chcbaram/macro-touchpad/hadware/V1.0/BOM_MAIN-BD_PCB_2023-05-19.xlsx

No. | Quantity | Comment | Designator | Footprint | Value | Manufacturer Part | Manufacturer | Supplier Part | Supplier
1 | 3 | 10uF | C1,C8,C12 | C1206 | 10uF | CL31A106KBHNNNE | SAMSUNG(三星) | C13585 | LCSC
2 | 11 | 100nF | C2,C17,C18,C19,C20,C21,C22,C23,C24,C25,C26 | C0402 | 100nF | CL05B104KB54PNC | SAMSUNG(三星) | C307331 | LCSC
3 | 4 | 1uF | C3,C6,C7,C14 | C0402 | 1uF | CL05A105KA5NQNC | SAMSUNG(三星) | C52923 | LCSC
4 | 5 | 10pF | C4,C5,C13,C15,C16 | C0402 | 10pF | CL05C100JB5NNNC | SAMSUNG(三星) | C32949 | LCSC
5 | 2 | 10uF | C9,C10 | C0603 | 10uF | C0603X5R106M100NT | SANYEAR(叁叶源) | C466780 | LCSC
6 | 1 | 1uF | C11 | C0603 | 1uF | CL10A105KB8NNNC | SAMSUNG(三星) | C15849 | LCSC
7 | 8 | 533980471 | CN1,CN3,CN5,CN7,CN8,CN9,CN11,CN12 | CONN-SMD_4P-P1.25_533980471 |  | 533980471 | MOLEX | C234195 | LCSC
8 | 4 | 0533980271 | CN2,CN4,CN6,CN10 | CONN-SMD_2P-P1.25_053398-0X71 |  | 0533980271 | MOLEX | C122410 | LCSC
9 | 2 | NSR0320MW2T1G | D1,D3 | SOD-323_L1.8-W1.3-LS2.5-RD |  | NSR0320MW2T1G | onsemi(安森美) | C48192 | LCSC
10 | 1 | MSK4010 | D2 | SOD-523_L1.2-W0.8-LS1.6-RD |  | MSK4010 | SHIKUES(时科) | C345958 | LCSC
11 | 1 | FPC-05FB-40PH20 | FPC1 | FPC-SMD_40P-P0.50_XUNPU_FPC-05FB-40PH20 |  | FPC-05FB-40PH20 | XUNPU(讯普) | C2856837 | LCSC
12 | 8 | HOLE | H1,H2,H3,H4,H5,H6,H7,H8 | HOLEHOLE
13 | 1 | 10uH | L1 | IND-SMD_L2.5-W2.0-1 | 10uH | VLS252012HBU-100M | TDK | C434844 | LCSC
14 | 1 | GHC-YR1S2-EMERALD | LED1 | LED0603-RD |  | GHC-YR1S2-EMERALD | EVERLIGHT(亿光) | C72043 | LCSC
15 | 1 | Y2C-CQ2R2L-YELLOW | LED2 | LED0603-RD-YELLOW |  | Y2C-CQ2R2L-YELLOW | EVERLIGHT(亿光) | C72038 | LCSC
16 | 2 | 19-213/Y2C-CQ2R2L/3T(CY) | LED4,LED5 | LED0603-RD-YELLOW |  | 19-213/Y2C-CQ2R2L/3T(CY) | EVERLIGHT(亿光) | C72038 | LCSC
17 | 1 | XL-1608SURC-06 | LED7 | LED0603-RD_RED |  | XL-1608SURC-06 | XINGLIGHT(成兴光) | C965799 | LCSC
18 | 1 | WS2812C-2020-V1 | LED8 | LED-SMD_4P-L2.0-W2.0-TL_WS2812B-2020 |  | WS2812C-2020-V1 | worldsemi | C2976072 | LCSC
19 | 2 | DMG3415U-7 | Q1,Q2 | SOT-23-3_L2.9-W1.6-P1.90-LS2.8-BR-CW |  | DMG3415U-7 | DIODES(美台) | C96616 | LCSC
20 | 1 | MMBT2222A 1P | Q3 | SOT-23-3_L2.9-W1.3-P1.90-LS2.4-BR |  | MMBT2222A 1P | CJ(江苏长电/长晶) | C8512 | LCSC
21 | 1 | FS8205 | Q4 | SOT-23-6_L2.9-W1.6-P0.95-LS2.8-BR |  | FS8205 | FORTUNE(富晶) | C32254 | LCSC
22 | 5 | 0Ω | R1,R5,R6,R15,R19 | R0402 | 0Ω | 0402WGF0000TCE | UNI-ROYAL(厚声) | C17168 | LCSC
23 | 13 | 10kΩ | R2,R8,R11,R16,R27,R28,R29,R32,R33,R34,R35,R36,R37 | R0402 | 10kΩ | 0402WGF1002TCE | UNI-ROYAL(厚声) | C25744 | LCSC
24 | 2 | 27Ω | R3,R4 | R0402 | 27Ω | 0402WGF270JTCE | UNI-ROYAL(厚声) | C25100 | LCSC
25 | 3 | 5.1kΩ | R7,R17,R20 | R0402 | 5.1kΩ | 0402WGF5101TCE | UNI-ROYAL(厚声) | C25905 | LCSC
26 | 6 | 1kΩ | R9,R12,R14,R24,R40,R42 | R0402 | 1kΩ | 0402WGF1001TCE | UNI-ROYAL(厚声) | C11702 | LCSC
27 | 3 | 100kΩ | R10,R38,R39 | R0402 | 100kΩ | 0402WGF1003TCE | UNI-ROYAL(厚声) | C25741 | LCSC
28 | 3 | 470Ω | R13,R43,R44 | R0402 | 470Ω | 0402WGF4700TCE | UNI-ROYAL(厚声) | C25117 | LCSC
29 | 1 | 2.74Ω | R22 | R0603 | 2.74Ω | RS-03L2R74FT | FH(风华) | C322128 | LCSC
30 | 1 | 1MΩ | R23 | R0603 | 1MΩ | 0603WAF1004T5E | UNI-ROYAL(厚声) | C22935 | LCSC
31 | 4 | 120Ω | R25,R26,R30,R31 | R0603 | 120Ω | 0603WAF1200T5E | UNI-ROYAL(厚声) | C22787 | LCSC
32 | 1 | 100Ω | R41 | R0402 | 100Ω | 0402WGF1000TCE | UNI-ROYAL(厚声) | C25076 | LCSC
33 | 1 | 3.3kΩ | R45 | R0402 | 3.3kΩ | 0402WGF3301TCE | UNI-ROYAL(厚声) | C25890 | LCSC
34 | 3 | SKRPACE010 | SW1,SW2,SW3 | KEY-SMD_4P-L4.2-W3.2-P2.20-LS4.6 |  | SKRPACE010 | ALPSALPINE(阿尔卑斯阿尔派) | C139797 | LCSC
35 | 2 | Device_RotaryEncoder_Switch | SW4,SW5 | Rotary_Encoder:RotaryEncoder_Alps_EC11E-Switch_Vertical_H20mm | RotaryEncoder_Switch
36 | 2 | DHN-04-V-T/R | SW6,SW7 | SW-TH_DHN-04-V-T-R |  | DHN-04-V-T/R | 圜达 | C224996 | LCSC
37 | 1 | ESP32-S3-WROOM-1-N16R8 | U1 | WIRELM-SMD_ESP32-S3-WROOM-1 |  | ESP32-S3-WROOM-1-N16R8 | ESPRESSIF(乐鑫) | C2913202 | LCSC
38 | 4 | SP3485EEN | U2,U5,U20,U21 | SOP-8_L5.0-W4.0-P1.27-LS6.0-BL |  | SP3485EEN | UMW(广东友台半导体) | C668205 | LCSC
39 | 1 | XC6210B332MR | U3 | TSOT-23-5_L2.9-W1.6-P0.95-LS2.8-BR |  | XC6210B332MR | TOREX(特瑞仕) | C424705 | LCSC
40 | 1 | TP4056-42-ESOP8 | U4 | ESOP-8_L4.9-W3.9-P1.27-LS6.0-BL-EP |  | TP4056-42-ESOP8 | TOPPOWER(南京拓微) | C16581 | LCSC
41 | 2 | 533980671 | U6,U19 | CONN-SMD_6P-P1.25-V-M_533980671 |  | 533980671 | MOLEX | C277393 | LCSC
42 | 1 | STM32G070CBT6 | U7 | LQFP-48_L7.0-W7.0-P0.50-LS9.0-BL |  | STM32G070CBT6 | ST(意法半导体) | C529338 | LCSC
43 | 1 | TXB0101DBVR | U9 | SOT-23-6_L2.9-W1.6-P0.95-LS2.8-TL |  | TXB0101DBVR | TI(德州仪器) | C2652944 | LCSC
44 | 1 | MT9284-28J | U10 | SOT-23-6_L2.9-W1.6-P0.95-LS2.8-BR |  | MT9284-28J | 西安航天民芯 | C181780 | LCSC
45 | 1 | MAX98357AETE+T | U11 | TQFN-16_L3.0-W3.0-P0.50-BL-EP1.5 |  | MAX98357AETE+T | ADI(亚德诺)/MAXIM(美信) | C910544 | LCSC
46 | 1 | STM32G031G8U6 | U12 | UFQFPN-28_L4.0-W4.0-P0.50-BL |  | STM32G031G8U6 | ST(意法半导体) | C432211 | LCSC
47 | 1 | TTP233H-BA6 | U17 | SOT-23-6_L2.9-W1.7-P0.95-LS2.8-BL |  | TTP233H-BA6 | TONTEK(通泰) | C2890349 | LCSC
48 | 1 | SN74LVC1G74DCUR | U18 | SSOP-8_L2.0-W2.3-P0.50-LS3.1-BR |  | SN74LVC1G74DCUR | TI(德州仪器) | C70285 | LCSC
49 | 1 | DW01A | U23 | SOT-23-6_L2.9-W1.6-P0.95-LS2.8-BL |  | DW01A | TF(拓锋) | C436931 | LCSC
50 | 1 | 8MHz | X1 | CRYSTAL-SMD_4P-L3.2-W2.5-BL-2 | 8MHz | 7B008000I01 | HD(浩都频率) | C648985 | LCSC
