chcbaram/macro-touchpad/hadware/V1.0/Gerber_PCB_2023-05-19/How-to-order-PCB.txt

How to Order PCB

Please refer to:
https://docs.easyeda.com/en/PCB/Order-PCB
