chcbaram/macro-touchpad/hadware/V1.0/PDF_MACRO-TOUCHPAD_2023-05-19.pdf

IO0 27 IO35 28 IO36 29 IO37 30 IO38 31 IO39 32 IO40 33 IO41 34 IO42 35 RXD0 36 TXD0 37 IO2 38 IO1 39 GND 40

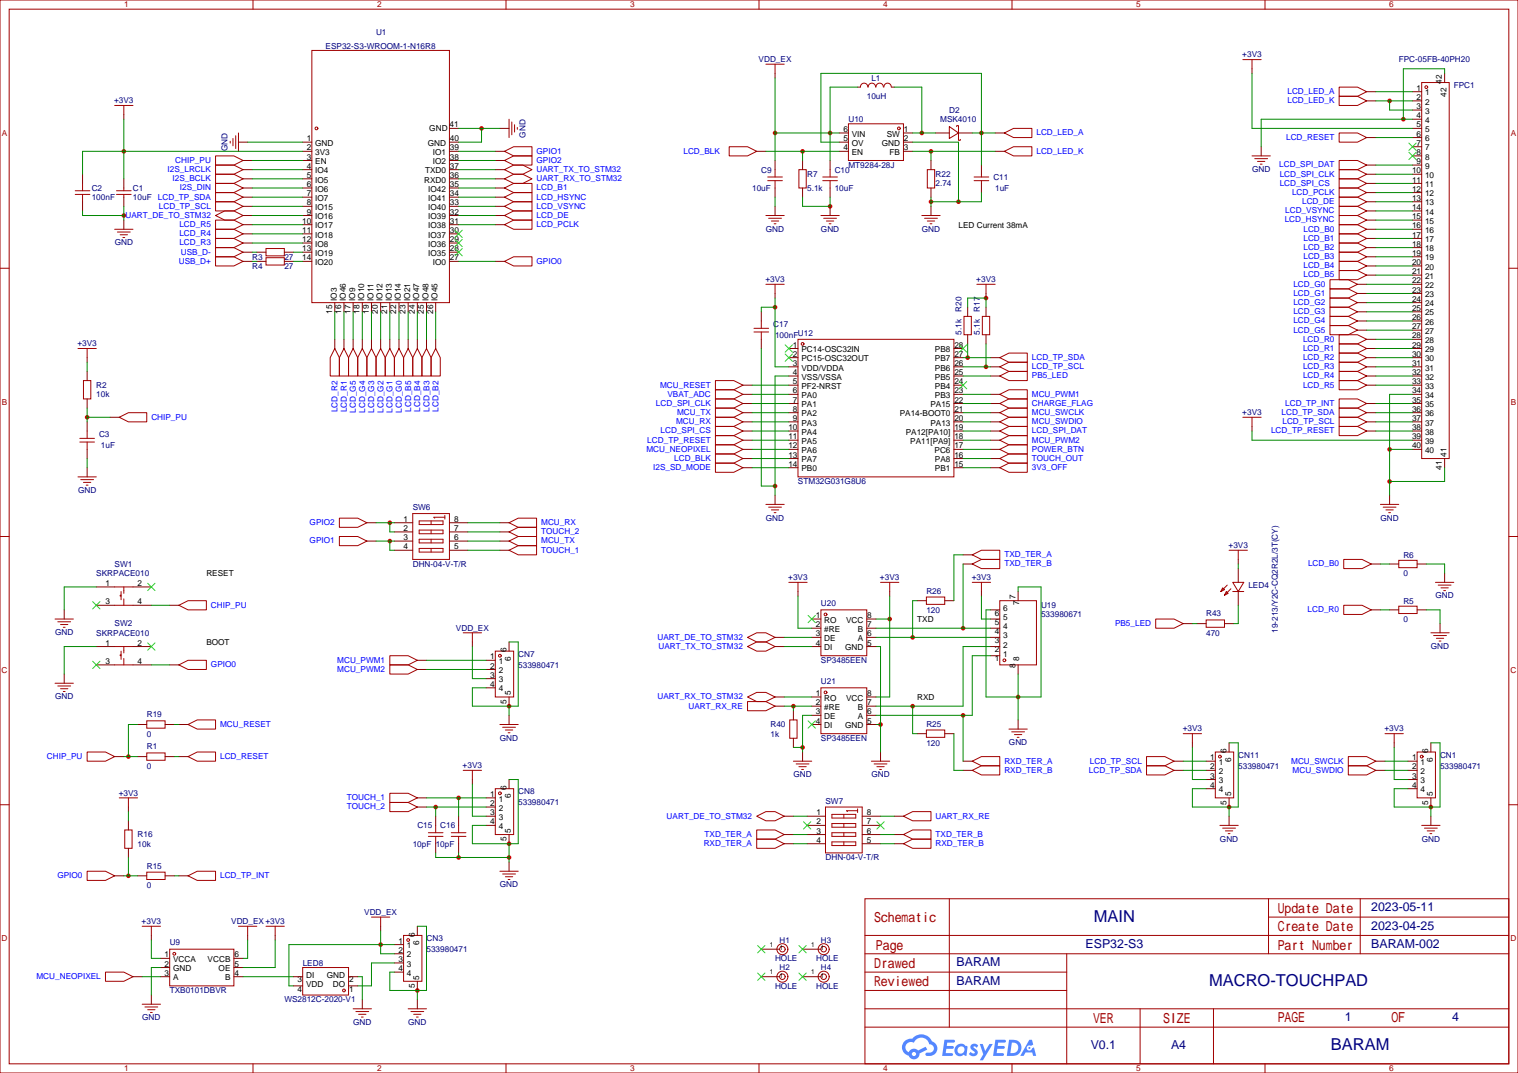
[picture p1: page 1]

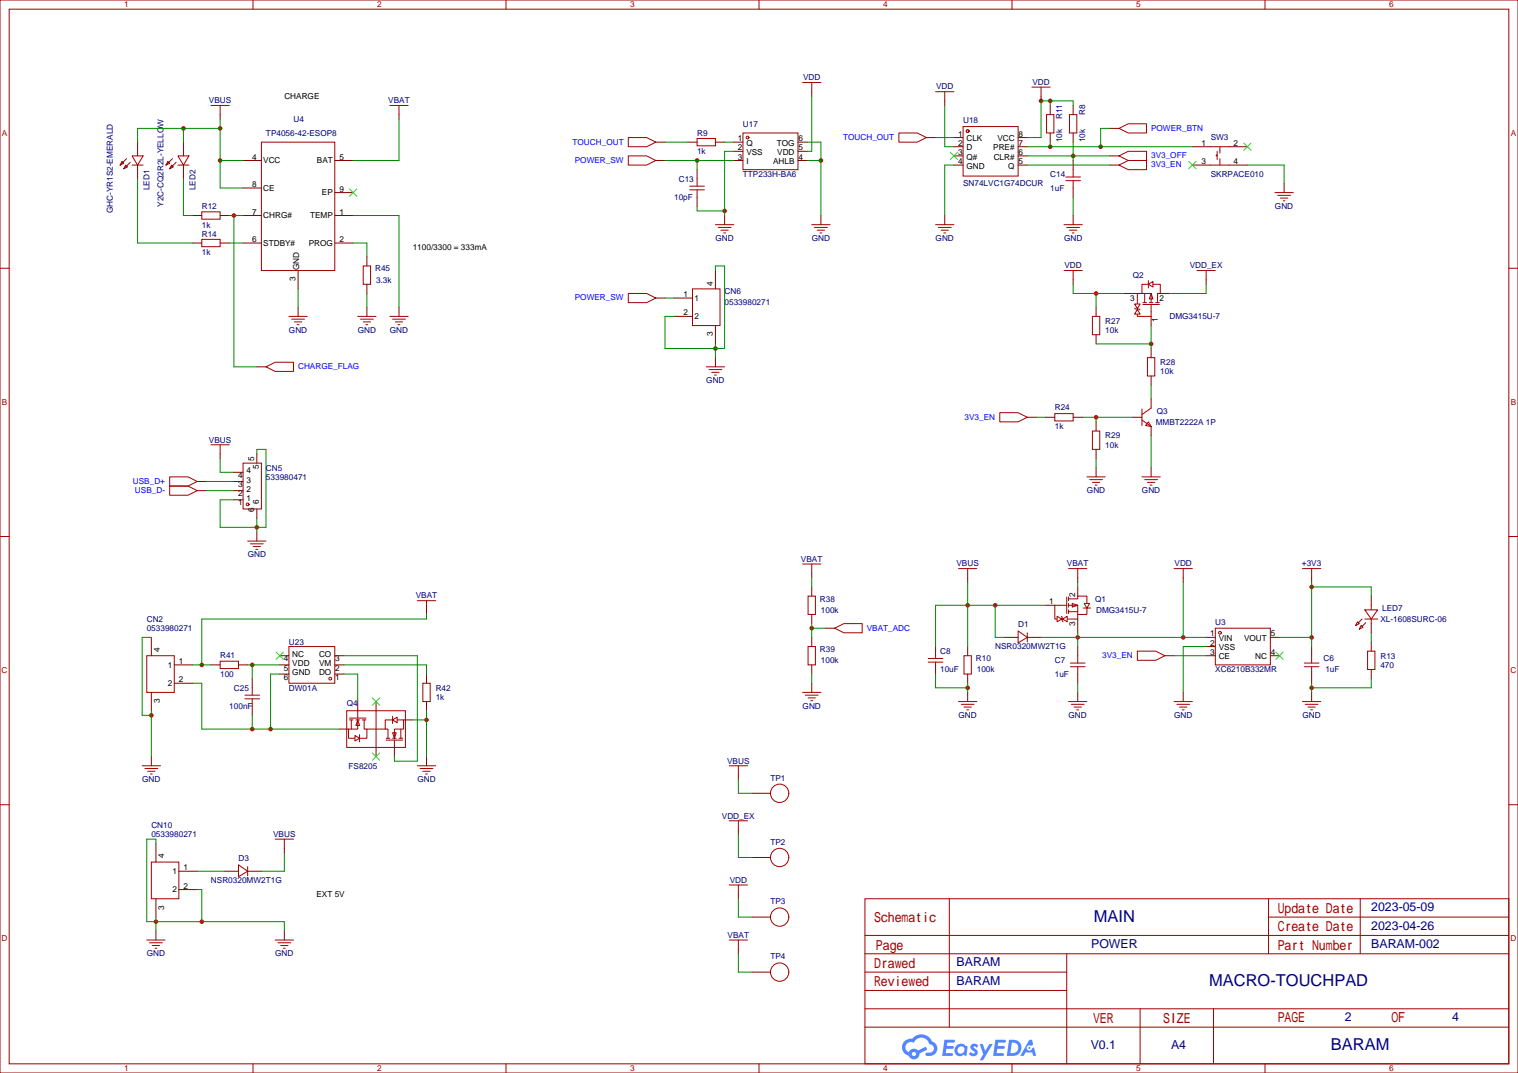
[picture p2: page 2]

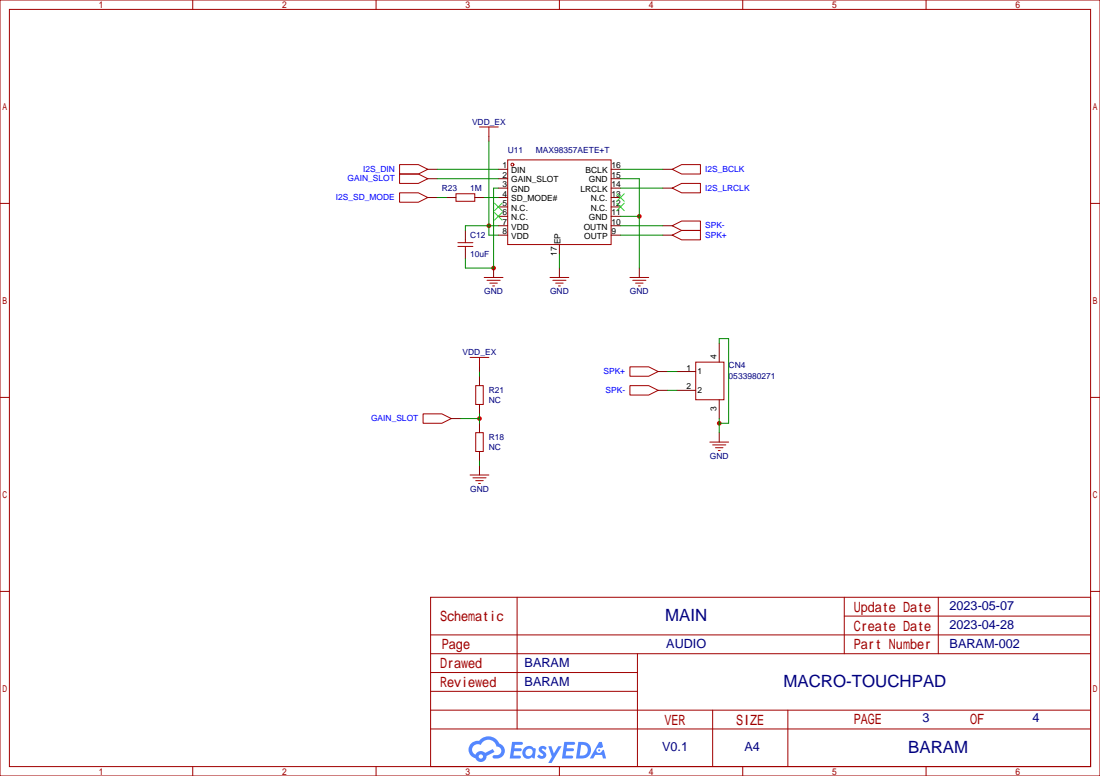
[picture p3: page 3]

OUTN 10 GND 11 N.C. 12 N.C. 13 LRCLK 14 GND 15 BCLK 16

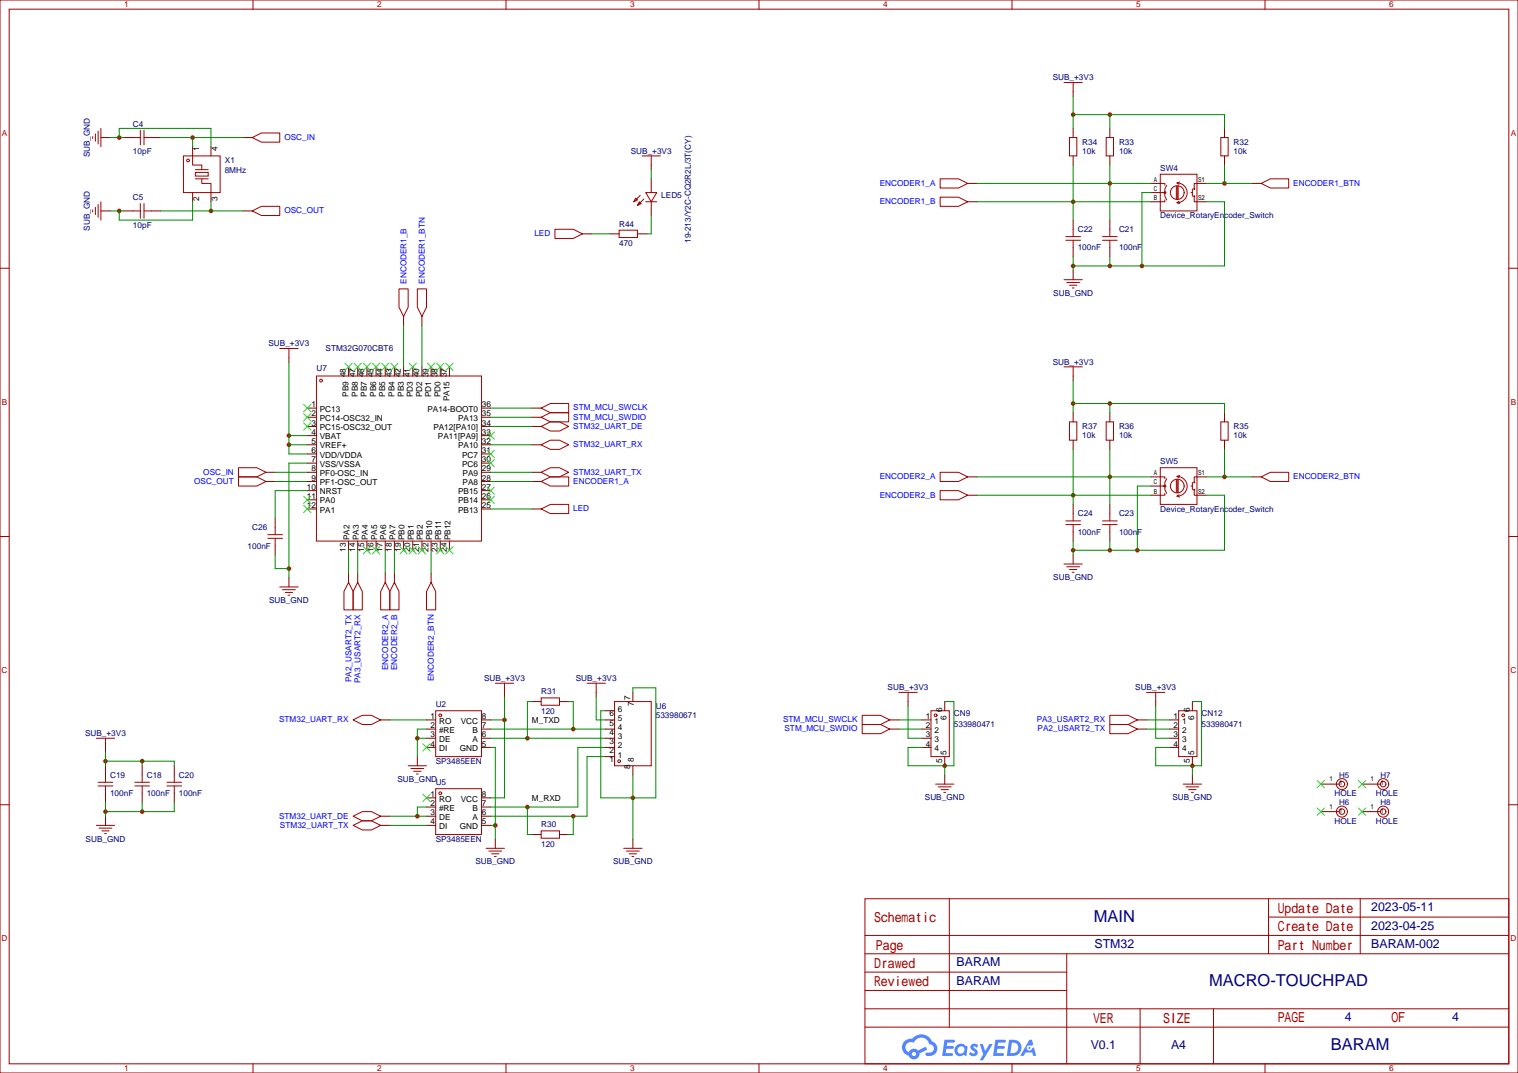
[picture p4: page 4]
