chcbaram/macro-touchpad/firmware/main-bd/stm32g031/cube/stm32g031g8.ioc

Mcu.UserName=STM32G031G8Ux
PA0.Signal=ADC1_IN0
PA1.Signal=SPI1_SCK
PA13.Signal=SYS_SWDIO
PA14-BOOT0.Signal=SYS_SWCLK
PA15.GPIO_Label=CHARGE_FLAG
PA15.Signal=GPIO_Input
PA2.Signal=USART2_TX
PA3.Signal=USART2_RX
PA4.Signal=SPI1_NSS
PA5.GPIO_Label=LCD_TP_RESET
PA5.Signal=GPIO_Output
PA6.Signal=S_TIM3_CH1
PA7.Signal=S_TIM14_CH1
PA8.GPIO_Label=TOUCH_OUT
PA8.Signal=GPIO_Input
PB0.GPIO_Label=I2S_SD_MODE
PB0.Signal=GPIO_Output
PB1.GPIO_Label=V3V3_OFF
PB1.Signal=GPIO_Output
PB3.Signal=S_TIM1_CH2
PB5.GPIO_Label=PB5_LED
PB5.Signal=GPIO_Output
PB6.Signal=I2C1_SCL
PB7.Signal=I2C1_SDA
PC6.GPIO_Label=POWER_BTN
PC6.Signal=GPIO_Input
