chcbaram/macro-touchpad/firmware/main-bd/stm32g031/cube/Core/Inc/main.h

#define LCD_TP_RESET_Pin GPIO_PIN_5
#define LCD_TP_RESET_GPIO_Port GPIOA
#define I2S_SD_MODE_Pin GPIO_PIN_0
#define I2S_SD_MODE_GPIO_Port GPIOB
#define V3V3_OFF_Pin GPIO_PIN_1
#define V3V3_OFF_GPIO_Port GPIOB
#define TOUCH_OUT_Pin GPIO_PIN_8
#define TOUCH_OUT_GPIO_Port GPIOA
#define POWER_BTN_Pin GPIO_PIN_6
#define POWER_BTN_GPIO_Port GPIOC
#define CHARGE_FLAG_Pin GPIO_PIN_15
#define CHARGE_FLAG_GPIO_Port GPIOA
#define PB5_LED_Pin GPIO_PIN_5
#define PB5_LED_GPIO_Port GPIOB
