chcbaram/macro-touchpad/firmware/main-bd/esp32-s3/components/esp32-s3-hal/hw/hw_def.h

/*
 * hw_def.h
 *
 *  Created on: 2021. 1. 9.
 *      Author: baram
 */

#ifndef MAIN_HW_HW_DEF_H_
#define MAIN_HW_HW_DEF_H_


#include "def.h"
#include "bsp.h"



#define _DEF_FIRMWATRE_VERSION    "V230520R1"
#define _DEF_BOARD_NAME           "MACRO-TOUCHPAD"



#define _HW_DEF_RTOS_THREAD_PRI_CLI           5
#define _HW_DEF_RTOS_THREAD_PRI_BUTTON        5
#define _HW_DEF_RTOS_THREAD_PRI_SD            5
#define _HW_DEF_RTOS_THREAD_PRI_LCD           5
#define _HW_DEF_RTOS_THREAD_PRI_GT911         5
#define _HW_DEF_RTOS_THREAD_PRI_I2S           5
#define _HW_DEF_RTOS_THREAD_PRI_AUDIO         5
#define _HW_DEF_RTOS_THREAD_PRI_BT_HIDH       5
#define _HW_DEF_RTOS_THREAD_PRI_BATTERY       5


#define _HW_DEF_RTOS_THREAD_MEM_CLI           (8*1024)
#define _HW_DEF_RTOS_THREAD_MEM_BUTTON        (1*1024)
#define _HW_DEF_RTOS_THREAD_MEM_SD            (4*1024)
#define _HW_DEF_RTOS_THREAD_MEM_LCD           (2*1024)
#define _HW_DEF_RTOS_THREAD_MEM_GT911         (4*1024)
#define _HW_DEF_RTOS_THREAD_MEM_I2S           (4*1024)
#define _HW_DEF_RTOS_THREAD_MEM_AUDIO         (8*1024)
#define _HW_DEF_RTOS_THREAD_MEM_BT_HIDH       (6*1024)
#define _HW_DEF_RTOS_THREAD_MEM_BATTERY       (2*1024)


#define _USE_HW_RTOS
#define _USE_HW_NVS
#define _USE_HW_CDC
#define _USE_HW_I2S
#define _USE_HW_BUZZER
#define _USE_HW_GT911
#define _USE_HW_LCDC
#define _USE_HW_I2C_EXP
#define _USE_HW_LVGL
#define _USE_HW_BATTERY

#define _USE_HW_UART
#define      HW_UART_MAX_CH         2

#define _USE_HW_CLI
#define      HW_CLI_CMD_LIST_MAX    32
#define      HW_CLI_CMD_NAME_MAX    16
#define      HW_CLI_LINE_HIS_MAX    8
#define      HW_CLI_LINE_BUF_MAX    64

#define _USE_HW_CLI_GUI
#define      HW_CLI_GUI_WIDTH       80
#define      HW_CLI_GUI_HEIGHT      24

#define _USE_HW_LOG
#define      HW_LOG_CH              _DEF_UART1
#define      HW_LOG_BOOT_BUF_MAX    1024
#define      HW_LOG_LIST_BUF_MAX    1024

#define _USE_HW_MIXER
#define      HW_MIXER_MAX_CH        8
#define      HW_MIXER_MAX_BUF_LEN   (16*4*8)

#define _USE_HW_AUDIO
#define      HW_AUDIO_CMD_MAX_CH    4

#define _USE_HW_I2C
#define      HW_I2C_MAX_CH          1

#define _USE_HW_TOUCH
#define      HW_TOUCH_MAX_CH        5

#define _USE_HW_GPIO
#define      HW_GPIO_MAX_CH         7

#define _USE_HW_PWM
#define      HW_PWM_MAX_CH          1

#define _USE_HW_ADC
#define      HW_ADC_MAX_CH          1


#define _USE_HW_LCDC

#define _USE_HW_ST7701
#define      HW_ST7701_WIDTH       480
#define      HW_ST7701_HEIGHT      480

#define _USE_HW_LCD
#define      HW_LCD_LVGL            1
#define      HW_LCD_LOGO            1
#define      HW_LCD_WIDTH           HW_ST7701_WIDTH
#define      HW_LCD_HEIGHT          HW_ST7701_HEIGHT


#define _PIN_GPIO_LCD_TS_RST        4
#define _PIN_GPIO_LCD_BLK           5
#define _PIN_GPIO_LCD_TS_INT        6


#endif 
