chcbaram/macro-touchpad/firmware/main-bd/esp32-s3/components/esp32-s3-hal/hw/driver/lcd.c

#include "lcd.h"
#include "cli.h"


#ifdef _USE_HW_LCD
#include "lcd/st7701.h"
#include "pwm.h"
#include "resize.h"
#include "hangul/han.h"
#include "lcd/lcd_fonts.h"
#include "touch.h"
#include "gpio.h"
#include "lcdc.h"
#include "qbuffer.h"


#define lock()        xSemaphoreTake(mutex_lock, portMAX_DELAY);
#define unLock()      xSemaphoreGive(mutex_lock);

#define LCD_OPT_DEF             __attribute__((optimize("O2")))
#define LCD_FRAME_BUF_MAX       3
#define LCD_FONT_RESIZE_WIDTH  64

#ifndef _swap_int16_t
#define _swap_int16_t(a, b) { int16_t t = a; a = b; b = t; }
#endif
#define MAKECOL(r, g, b) ( ((r)<<11) | ((g)<<5) | (b))


typedef struct
{
  uint16_t  *buffer[LCD_FRAME_BUF_MAX];
  uint32_t   index;
  uint16_t  *draw_buffer;
  bool       is_done[LCD_FRAME_BUF_MAX];
  qbuffer_t  q_event;
  uint8_t    q_buf[4];
} lcd_frame_t;

typedef struct
{
  QueueHandle_t evt_queue_vsync;
} lcd_event_t;

typedef struct
{
  int16_t x;
  int16_t y;
} lcd_pixel_t;


static bool lcdTransferDoneISR(void);
// static void lcdSwapFrameBuffer(void);
static void lcdDrawLineBuffer(int16_t x0, int16_t y0, int16_t x1, int16_t y1, uint16_t color, lcd_pixel_t *line);
static void cliLcd(cli_args_t *args);
static bool lcdLoadCfg(void);
static bool lcdSaveCfg(void);
static void lcdThread(void* arg);

static void disHanFont(int x, int y, han_font_t *FontPtr, uint16_t textcolor);
static void disEngFont(int x, int y, char ch, lcd_font_t *font, uint16_t textcolor);


static SemaphoreHandle_t mutex_lock;

static bool     is_init = false;
static bool     is_request_draw = false;
static uint32_t is_request_index = 0;


static lcd_frame_t lcd_frame;
static uint8_t backlight_value = 100;
static lcd_event_t lcd_event;

static volatile uint32_t fps_pre_time;
static volatile uint32_t fps_time;
static volatile uint32_t fps_count = 0;
static volatile int32_t  draw_fps = -1;
static volatile uint32_t draw_pre_time = 0;
static volatile uint32_t draw_frame_time = 0;

static uint16_t __attribute__((aligned(64))) font_src_buffer[16 * 16];
static uint16_t __attribute__((aligned(64))) font_dst_buffer[LCD_FONT_RESIZE_WIDTH * LCD_FONT_RESIZE_WIDTH];

static LcdFont lcd_font = LCD_FONT_HAN;
static lcd_font_t *font_tbl[LCD_FONT_MAX] = { &font_07x10, &font_11x18, &font_16x26, &font_hangul};

static LcdResizeMode lcd_resize_mode = LCD_RESIZE_NEAREST;

#if HW_LCD_LOGO > 0
LVGL_IMG_DEF(logo_img);
static bool is_logo_on = false;
#endif


bool lcdInit(void)
{
  bool ret = true;


  mutex_lock = xSemaphoreCreateMutex();


  ret = st7701Init();
  logPrintf("[%s] st7701Init()\n", ret ? "OK":"NG");

  ret = lcdcInit();
  logPrintf("[%s] lcdcInit()\n", ret ? "OK":"NG");

  lcdcSetCallBack(lcdTransferDoneISR);

  ret = lcdcBegin(LCD_WIDTH, LCD_HEIGHT, 16, 12);
  logPrintf("[%s] lcdcBegin()\n", ret ? "OK":"NG");

  if (ret != true)
    return false;
  

  lcd_frame.index = 0;
  for (int i=0; i<LCD_FRAME_BUF_MAX; i++)
  {
    lcd_frame.is_done[i] = false;
    lcd_frame.buffer[i] = lcdcGetFrameBuffer(i);

    if (lcd_frame.buffer[i] == NULL)
    {
      logPrintf("[NG] lcd frame buffer\n");
      break;
    }
  }
  qbufferCreate(&lcd_frame.q_event, lcd_frame.q_buf, 4);

  is_init = ret;

  if (ret == true)
  {
    lcd_frame.draw_buffer = lcd_frame.buffer[lcd_frame.index];

    for (int i=0; i<LCD_WIDTH*LCD_HEIGHT; i++)
    {
      lcd_frame.draw_buffer[i] = black;
    }
  }

  lcd_event.evt_queue_vsync = xQueueCreate(3, 0);
  xTaskCreate(lcdThread, "lcdThread", _HW_DEF_RTOS_THREAD_MEM_LCD, NULL, _HW_DEF_RTOS_THREAD_PRI_LCD, NULL);


  lcdUpdateDraw();
  logPrintf("[%s] lcdInit()\n", is_init ? "OK":"NG");

  #if HW_LCD_LOGO > 0
  lcdLogoOn();
  #endif

  lcdLoadCfg();
  lcdSetBackLight(backlight_value);

  cliAdd("lcd", cliLcd);
  return ret;
}

static void lcdThread(void* arg)
{
  while(1) 
  {
    if(xQueueReceive(lcd_event.evt_queue_vsync, NULL, portMAX_DELAY)) 
    {
      draw_frame_time = millis() - draw_pre_time;
      draw_pre_time = millis();

      // if (is_request_draw == true)
      if (qbufferAvailable(&lcd_frame.q_event) > 0)
      {
        uint8_t index;

        //index = lcd_frame.index;
        //lcdSwapFrameBuffer();
        qbufferRead(&lcd_frame.q_event, &index, 1);
        //lcdcRefreshFrameBuffer(lcd_frame.buffer[index]);
        is_request_draw = false;

        lcd_frame.is_done[index] = true;        
      }
    }
  }
}

bool lcdLoadCfg(void)
{
  bool ret = true;
  esp_err_t err;
  nvs_handle_t nvs_h;

  err = nvs_open("storage", NVS_READWRITE, &nvs_h);
  if (err == ESP_OK)
  {
    uint8_t pwm_value = backlight_value;

    if (nvs_get_u8(nvs_h, "lcd_cfg_pwm", &pwm_value) == ESP_ERR_NVS_NOT_FOUND)
    {
      pwm_value = backlight_value;
    }
    backlight_value = pwm_value;
    nvs_close(nvs_h);
  }

  return ret;
}

bool lcdSaveCfg(void)
{
  bool ret = true;
  esp_err_t err;
  nvs_handle_t nvs_h;

  err = nvs_open("storage", NVS_READWRITE, &nvs_h);
  if (err == ESP_OK)
  {
    nvs_set_u8(nvs_h, "lcd_cfg_pwm", backlight_value);
    nvs_commit(nvs_h);
    nvs_close(nvs_h);
  }

  return ret;
}

uint8_t lcdGetBackLight(void)
{
  return backlight_value;
}

void lcdSetBackLight(uint8_t value)
{
  value = constrain((int8_t)value, 0, 100);

  if (value != backlight_value)
  {
    backlight_value = value;
  }

  lcdSaveCfg();

  #ifdef _USE_HW_PWM
  uint8_t pwm_out;

  pwm_out = cmap(backlight_value, 0, 100, 0, 255);
  pwmWrite(_DEF_PWM1, pwm_out);
  #else
  if (backlight_value > 0)
    gpioPinWrite(_PIN_GPIO_LCD_BLK, _DEF_HIGH);
  else
    gpioPinWrite(_PIN_GPIO_LCD_BLK, _DEF_LOW);
  #endif
}

IRAM_ATTR bool lcdTransferDoneISR(void)
{
  BaseType_t high_task_wakeup;

  xQueueSendFromISR(lcd_event.evt_queue_vsync, NULL, &high_task_wakeup);
  return high_task_wakeup == pdTRUE;
}

bool lcdRequestDraw(void)
{
  if (is_init != true) return false;
  // if (is_request_draw == true) return false;

  is_request_index = lcd_frame.index;
  lcd_frame.is_done[lcd_frame.index] = false;
  // is_request_draw = true;
  // lcdcRefreshFrameBuffer(lcdGetFrameBuffer());

  qbufferWrite(&lcd_frame.q_event, (uint8_t *)&lcd_frame.index, 1);
  lcdcRefreshFrameBuffer(lcd_frame.buffer[lcd_frame.index]);

  lcd_frame.index = (lcd_frame.index + 1) % LCD_FRAME_BUF_MAX;
  lcd_frame.draw_buffer = lcd_frame.buffer[lcd_frame.index];

  fps_time = millis() - fps_pre_time;
  fps_pre_time = millis();

  if (fps_time > 0)
  {
    fps_count = 1000 / fps_time;
  }
  return true;
}

void lcdUpdateDraw(void)
{
  uint32_t pre_time;

  if (is_init != true)
  {
    return;
  }

  lcdRequestDraw();

  pre_time = millis();
  while(1)
  {
    delay(1);
    if (lcd_frame.is_done[is_request_index] == true)
    {
      break;
    }
    if (millis()-pre_time >= 100)
    {
      break;
    }
  }
}

bool lcdDrawAvailable(void)
{
  bool ret = false;
 
  // ret = !is_request_draw;

  if (qbufferAvailable(&lcd_frame.q_event) < 3)
  {
    ret = true;
  }

  return ret;
}

uint16_t *lcdGetFrameBuffer(void)
{
  return (uint16_t *)lcd_frame.draw_buffer;
}

uint16_t *lcdGetCurrentFrameBuffer(void)
{
  return (uint16_t *)lcd_frame.buffer[(lcd_frame.index + 1)%LCD_FRAME_BUF_MAX];
}

LCD_OPT_DEF IRAM_ATTR void lcdClearBuffer(uint32_t rgb_code)
{
  uint16_t *p_buf = lcdGetFrameBuffer();

  for (int i=0; i<LCD_WIDTH * LCD_HEIGHT; i++)
  {
    p_buf[i] = rgb_code;
  }
}

// void lcdSwapFrameBuffer(void)
// {
//   lock();
//   lcd_frame.index ^= 1;
//   lcd_frame.draw_buffer = lcd_frame.buffer[lcd_frame.index];
//   unLock();
// }

uint32_t lcdGetDrawTime(void)
{
  return draw_frame_time;
}

bool lcdIsInit(void)
{
  return is_init;
}

LCD_OPT_DEF inline uint32_t lcdReadPixel(uint16_t x_pos, uint16_t y_pos)
{
  return lcd_frame.draw_buffer[y_pos * LCD_WIDTH + x_pos];
}

LCD_OPT_DEF inline void IRAM_ATTR lcdDrawPixel(int16_t x_pos, int16_t y_pos, uint32_t rgb_code)
{
  if (x_pos < 0 || x_pos >= LCD_WIDTH) return;
  if (y_pos < 0 || y_pos >= LCD_HEIGHT) return;

  lcd_frame.draw_buffer[y_pos * LCD_WIDTH + x_pos] = rgb_code;
}

LCD_OPT_DEF void lcdClear(uint32_t rgb_code)
{
  lcdClearBuffer(rgb_code);

  lcdUpdateDraw();
}

LCD_OPT_DEF void lcdDrawFillCircle(int32_t x0, int32_t y0, int32_t r, uint16_t color)
{
  int32_t  x  = 0;
  int32_t  dx = 1;
  int32_t  dy = r+r;
  int32_t  p  = -(r>>1);


  lcdDrawHLine(x0 - r, y0, dy+1, color);

  while(x<r)
  {

    if(p>=0) 
    {
      dy-=2;
      p-=dy;
      r--;
    }

    dx+=2;
    p+=dx;

    x++;

    lcdDrawHLine(x0 - r, y0 + x, 2 * r+1, color);
    lcdDrawHLine(x0 - r, y0 - x, 2 * r+1, color);
    lcdDrawHLine(x0 - x, y0 + r, 2 * x+1, color);
    lcdDrawHLine(x0 - x, y0 - r, 2 * x+1, color);
  }
}

LCD_OPT_DEF void lcdDrawCircleHelper( int32_t x0, int32_t y0, int32_t r, uint8_t cornername, uint32_t color)
{
  int32_t f     = 1 - r;
  int32_t ddF_x = 1;
  int32_t ddF_y = -2 * r;
  int32_t x     = 0;

  while (x < r)
  {
    if (f >= 0)
    {
      r--;
      ddF_y += 2;
      f     += ddF_y;
    }
    x++;
    ddF_x += 2;
    f     += ddF_x;
    if (cornername & 0x4)
    {
      lcdDrawPixel(x0 + x, y0 + r, color);
      lcdDrawPixel(x0 + r, y0 + x, color);
    }
    if (cornername & 0x2)
    {
      lcdDrawPixel(x0 + x, y0 - r, color);
      lcdDrawPixel(x0 + r, y0 - x, color);
    }
    if (cornername & 0x8)
    {
      lcdDrawPixel(x0 - r, y0 + x, color);
      lcdDrawPixel(x0 - x, y0 + r, color);
    }
    if (cornername & 0x1)
    {
      lcdDrawPixel(x0 - r, y0 - x, color);
      lcdDrawPixel(x0 - x, y0 - r, color);
    }
  }
}

LCD_OPT_DEF void lcdDrawRoundRect(int32_t x, int32_t y, int32_t w, int32_t h, int32_t r, uint32_t color)
{
  // smarter version
  lcdDrawHLine(x + r    , y        , w - r - r, color); // Top
  lcdDrawHLine(x + r    , y + h - 1, w - r - r, color); // Bottom
  lcdDrawVLine(x        , y + r    , h - r - r, color); // Left
  lcdDrawVLine(x + w - 1, y + r    , h - r - r, color); // Right

  // draw four corners
  lcdDrawCircleHelper(x + r        , y + r        , r, 1, color);
  lcdDrawCircleHelper(x + w - r - 1, y + r        , r, 2, color);
  lcdDrawCircleHelper(x + w - r - 1, y + h - r - 1, r, 4, color);
  lcdDrawCircleHelper(x + r        , y + h - r - 1, r, 8, color);
}

LCD_OPT_DEF void lcdDrawFillCircleHelper(int32_t x0, int32_t y0, int32_t r, uint8_t cornername, int32_t delta, uint32_t color)
{
  int32_t f     = 1 - r;
  int32_t ddF_x = 1;
  int32_t ddF_y = -r - r;
  int32_t y     = 0;

  delta++;

  while (y < r)
  {
    if (f >= 0)
    {
      r--;
      ddF_y += 2;
      f     += ddF_y;
    }

    y++;
    ddF_x += 2;
    f     += ddF_x;

    if (cornername & 0x1)
    {
      lcdDrawHLine(x0 - r, y0 + y, r + r + delta, color);
      lcdDrawHLine(x0 - y, y0 + r, y + y + delta, color);
    }
    if (cornername & 0x2)
    {
      lcdDrawHLine(x0 - r, y0 - y, r + r + delta, color); // 11995, 1090
      lcdDrawHLine(x0 - y, y0 - r, y + y + delta, color);
    }
  }
}

LCD_OPT_DEF void lcdDrawFillRoundRect(int32_t x, int32_t y, int32_t w, int32_t h, int32_t r, uint32_t color)
{
  // smarter version
  lcdDrawFillRect(x, y + r, w, h - r - r, color);

  // draw four corners
  lcdDrawFillCircleHelper(x + r, y + h - r - 1, r, 1, w - r - r - 1, color);
  lcdDrawFillCircleHelper(x + r, y + r        , r, 2, w - r - r - 1, color);
}

LCD_OPT_DEF void lcdDrawTriangle(int32_t x1, int32_t y1, int32_t x2, int32_t y2, int32_t x3, int32_t y3, uint32_t color)
{
  lcdDrawLine(x1, y1, x2, y2, color);
  lcdDrawLine(x1, y1, x3, y3, color);
  lcdDrawLine(x2, y2, x3, y3, color);
}

LCD_OPT_DEF void lcdDrawFillTriangle(int32_t x1, int32_t y1, int32_t x2, int32_t y2, int32_t x3, int32_t y3, uint32_t color)
{
  uint16_t max_line_size_12 = cmax(abs(x1-x2), abs(y1-y2));
  uint16_t max_line_size_13 = cmax(abs(x1-x3), abs(y1-y3));
  uint16_t max_line_size_23 = cmax(abs(x2-x3), abs(y2-y3));
  uint16_t max_line_size = max_line_size_12;
  uint16_t i = 0;

  if (max_line_size_13 > max_line_size)
  {
    max_line_size = max_line_size_13;
  }
  if (max_line_size_23 > max_line_size)
  {
    max_line_size = max_line_size_23;
  }

  lcd_pixel_t line[max_line_size];

  lcdDrawLineBuffer(x1, y1, x2, y2, color, line);
  for (i = 0; i < max_line_size_12; i++)
  {
    lcdDrawLine(x3, y3, line[i].x, line[i].y, color);
  }
  lcdDrawLineBuffer(x1, y1, x3, y3, color, line);
  for (i = 0; i < max_line_size_13; i++)
  {
    lcdDrawLine(x2, y2, line[i].x, line[i].y, color);
  }
  lcdDrawLineBuffer(x2, y2, x3, y3, color, line);
  for (i = 0; i < max_line_size_23; i++)
  {
    lcdDrawLine(x1, y1, line[i].x, line[i].y, color);
  }
}

void lcdSetFps(int32_t fps)
{
  draw_fps = fps;
}

uint32_t lcdGetFps(void)
{
  return fps_count;
}

uint32_t lcdGetFpsTime(void)
{
  return fps_time;
}

void lcdDisplayOff(void)
{
}

void lcdDisplayOn(void)
{
  lcdSetBackLight(lcdGetBackLight());
}

int32_t lcdGetWidth(void)
{
  return LCD_WIDTH;
}

int32_t lcdGetHeight(void)
{
  return LCD_HEIGHT;
}


LCD_OPT_DEF IRAM_ATTR void lcdDrawLine(int16_t x0, int16_t y0, int16_t x1, int16_t y1, uint16_t color)
{
  int16_t steep = abs(y1 - y0) > abs(x1 - x0);

  if (x0 < 0) x0 = 0;
  if (y0 < 0) y0 = 0;
  if (x1 < 0) x1 = 0;
  if (y1 < 0) y1 = 0;


  if (steep)
  {
    _swap_int16_t(x0, y0);
    _swap_int16_t(x1, y1);
  }

  if (x0 > x1)
  {
    _swap_int16_t(x0, x1);
    _swap_int16_t(y0, y1);
  }

  int16_t dx, dy;
  dx = x1 - x0;
  dy = abs(y1 - y0);

  int16_t err = dx / 2;
  int16_t ystep;

  if (y0 < y1)
  {
    ystep = 1;
  } else {
    ystep = -1;
  }

  for (; x0<=x1; x0++)
  {
    if (steep)
    {
      lcdDrawPixel(y0, x0, color);
    } else
    {
      lcdDrawPixel(x0, y0, color);
    }
    err -= dy;
    if (err < 0)
    {
      y0 += ystep;
      err += dx;
    }
  }
}

LCD_OPT_DEF IRAM_ATTR void lcdDrawLineBuffer(int16_t x0, int16_t y0, int16_t x1, int16_t y1, uint16_t color, lcd_pixel_t *line)
{
  int16_t steep = abs(y1 - y0) > abs(x1 - x0);

  if (x0 < 0) x0 = 0;
  if (y0 < 0) y0 = 0;
  if (x1 < 0) x1 = 0;
  if (y1 < 0) y1 = 0;


  if (steep)
  {
    _swap_int16_t(x0, y0);
    _swap_int16_t(x1, y1);
  }

  if (x0 > x1)
  {
    _swap_int16_t(x0, x1);
    _swap_int16_t(y0, y1);
  }

  int16_t dx, dy;
  dx = x1 - x0;
  dy = abs(y1 - y0);

  int16_t err = dx / 2;
  int16_t ystep;

  if (y0 < y1)
  {
    ystep = 1;
  } else {
    ystep = -1;
  }

  for (; x0<=x1; x0++)
  {
    if (steep)
    {
      if (line != NULL)
      {
        line->x = y0;
        line->y = x0;
      }
      lcdDrawPixel(y0, x0, color);
    } else
    {
      if (line != NULL)
      {
        line->x = x0;
        line->y = y0;
      }
      lcdDrawPixel(x0, y0, color);
    }
    if (line != NULL)
    {
      line++;
    }
    err -= dy;
    if (err < 0)
    {
      y0 += ystep;
      err += dx;
    }
  }
}

LCD_OPT_DEF IRAM_ATTR void lcdDrawVLine(int16_t x, int16_t y, int16_t h, uint16_t color)
{
  lcdDrawLine(x, y, x, y+h-1, color);
}

LCD_OPT_DEF IRAM_ATTR void lcdDrawHLine(int16_t x, int16_t y, int16_t w, uint16_t color)
{
  lcdDrawLine(x, y, x+w-1, y, color);
}

LCD_OPT_DEF IRAM_ATTR void lcdDrawFillRect(int16_t x, int16_t y, int16_t w, int16_t h, uint16_t color)
{
  for (int16_t i=x; i<x+w; i++)
  {
    lcdDrawVLine(i, y, h, color);
  }
}

LCD_OPT_DEF IRAM_ATTR void lcdDrawRect(int16_t x, int16_t y, int16_t w, int16_t h, uint16_t color)
{
  lcdDrawHLine(x, y, w, color);
  lcdDrawHLine(x, y+h-1, w, color);
  lcdDrawVLine(x, y, h, color);
  lcdDrawVLine(x+w-1, y, h, color);
}

LCD_OPT_DEF void lcdDrawFillScreen(uint16_t color)
{
  lcdDrawFillRect(0, 0, HW_LCD_WIDTH, HW_LCD_HEIGHT, color);
}

LCD_OPT_DEF void lcdPrintf(int x, int y, uint16_t color,  const char *fmt, ...)
{
  va_list arg;
  va_start (arg, fmt);
  int32_t len;
  char print_buffer[256];
  int Size_Char;
  int i, x_Pre = x;
  han_font_t FontBuf;
  uint8_t font_width;
  uint8_t font_height;


  len = vsnprintf(print_buffer, 255, fmt, arg);
  va_end (arg);

  if (font_tbl[lcd_font]->data != NULL)
  {
    for( i=0; i<len; i+=Size_Char )
    {
      disEngFont(x, y, print_buffer[i], font_tbl[lcd_font], color);

      Size_Char = 1;
      font_width = font_tbl[lcd_font]->width;
      font_height = font_tbl[lcd_font]->height;
      x += font_width;

      if ((x+font_width) > HW_LCD_WIDTH)
      {
        x  = x_Pre;
        y += font_height;
      }
    }
  }
  else
  {
    for( i=0; i<len; i+=Size_Char )
    {
      hanFontLoad( &print_buffer[i], &FontBuf );

      disHanFont( x, y, &FontBuf, color);

      Size_Char = FontBuf.Size_Char;
      if (Size_Char >= 2)
      {
        font_width = 16;
        x += 2*8;
      }
      else
      {
        font_width = 8;
        x += 1*8;
      }

      if ((x+font_width) > HW_LCD_WIDTH)
      {
        x  = x_Pre;
        y += 16;
      }

      if( FontBuf.Code_Type == PHAN_END_CODE ) break;
    }
  }
}


LCD_OPT_DEF uint32_t lcdGetStrWidth(const char *fmt, ...)
{
  va_list arg;
  va_start (arg, fmt);
  int32_t len;
  char print_buffer[256];
  int Size_Char;
  int i;
  han_font_t FontBuf;
  uint32_t str_len;


  len = vsnprintf(print_buffer, 255, fmt, arg);
  va_end (arg);

  str_len = 0;

  for( i=0; i<len; i+=Size_Char )
  {
    hanFontLoad( &print_buffer[i], &FontBuf );

    Size_Char = FontBuf.Size_Char;

    if (Size_Char >= 2)
    {
      str_len += (2 * 8);
    }
    else
    {
      str_len += (1 * 8);
    }
    if( FontBuf.Code_Type == PHAN_END_CODE ) break;
  }

  return str_len;
}

LCD_OPT_DEF void disHanFont(int x, int y, han_font_t *FontPtr, uint16_t textcolor)
{
  uint16_t    i, j, Loop;
  uint16_t  FontSize = FontPtr->Size_Char;
  uint16_t index_x;

  if (FontSize > 2)
  {
    FontSize = 2;
  }

  for ( i = 0 ; i < 16 ; i++ )        // 16 Lines per Font/Char
  {
    index_x = 0;
    for ( j = 0 ; j < FontSize ; j++ )      // 16 x 16 (2 Bytes)
    {
      uint8_t font_data;

      font_data = FontPtr->FontBuffer[i*FontSize +j];

      for( Loop=0; Loop<8; Loop++ )
      {
        if( (font_data<<Loop) & (0x80))
        {
          lcdDrawPixel(x + index_x, y + i, textcolor);
        }
        index_x++;
      }
    }
  }
}

LCD_OPT_DEF void disEngFont(int x, int y, char ch, lcd_font_t *font, uint16_t textcolor)
{
  uint32_t i, b, j;


  // We gaan door het font
  for (i = 0; i < font->height; i++)
  {
    b = font->data[(ch - 32) * font->height + i];
    for (j = 0; j < font->width; j++)
    {
      if ((b << j) & 0x8000)
      {
        lcdDrawPixel(x + j, (y + i), textcolor);
      }
    }
  }
}

void lcdSetFont(LcdFont font)
{
  lcd_font = font;
}

LcdFont lcdGetFont(void)
{
  return lcd_font;
}

LCD_OPT_DEF void lcdDrawPixelBuffer(int16_t x_pos, int16_t y_pos, uint32_t rgb_code)
{
  font_src_buffer[y_pos * 16 + x_pos] = rgb_code;
}

LCD_OPT_DEF void disHanFontBuffer(int x, int y, han_font_t *FontPtr, uint16_t textcolor)
{
  uint16_t    i, j, Loop;
  uint16_t  FontSize = FontPtr->Size_Char;
  uint16_t index_x;

  if (FontSize > 2)
  {
    FontSize = 2;
  }

  if (textcolor == 0)
  {
    textcolor = 1;
  }
  for ( i = 0 ; i < 16 ; i++ )        // 16 Lines per Font/Char
  {
    index_x = 0;
    for ( j = 0 ; j < FontSize ; j++ )      // 16 x 16 (2 Bytes)
    {
      uint8_t font_data;

      font_data = FontPtr->FontBuffer[i*FontSize +j];

      for( Loop=0; Loop<8; Loop++ )
      {
        if(font_data & ((uint8_t)0x80>>Loop))
        {
          lcdDrawPixelBuffer(index_x, i, textcolor);
        }
        else
        {
          lcdDrawPixelBuffer(index_x, i, 0);
        }
        index_x++;
      }
    }
  }
}

LCD_OPT_DEF uint16_t lcdGetColorMix(uint16_t c1_, uint16_t c2_, uint8_t mix)
{
  uint16_t r, g, b;
  uint16_t ret;
  uint16_t c1;
  uint16_t c2;

#if 0
  c1 = ((c1_>>8) & 0x00FF) | ((c1_<<8) & 0xFF00);
  c2 = ((c2_>>8) & 0x00FF) | ((c2_<<8) & 0xFF00);
#else
  c1 = c1_;
  c2 = c2_;
#endif
  r = ((uint16_t)((uint16_t) GETR(c1) * mix + GETR(c2) * (255 - mix)) >> 8);
  g = ((uint16_t)((uint16_t) GETG(c1) * mix + GETG(c2) * (255 - mix)) >> 8);
  b = ((uint16_t)((uint16_t) GETB(c1) * mix + GETB(c2) * (255 - mix)) >> 8);

  ret = MAKECOL(r, g, b);



  //return ((ret>>8) & 0xFF) | ((ret<<8) & 0xFF00);;
  return ret;
}

LCD_OPT_DEF void lcdDrawPixelMix(int16_t x_pos, int16_t y_pos, uint32_t rgb_code, uint8_t mix)
{
  uint16_t color1, color2;
  uint32_t buf_index;

  if (x_pos < 0 || x_pos >= LCD_WIDTH) return;
  if (y_pos < 0 || y_pos >= LCD_HEIGHT) return;

  
  buf_index = y_pos * LCD_WIDTH + x_pos;

  color1 = lcd_frame.draw_buffer[buf_index];
  color2 = rgb_code;

  lcd_frame.draw_buffer[buf_index] = lcdGetColorMix(color1, color2, 255-mix);
}

LCD_OPT_DEF void lcdPrintfResize(int x, int y, uint16_t color,  float ratio_h, const char *fmt, ...)
{
  va_list arg;
  va_start (arg, fmt);
  int32_t len;
  char print_buffer[256];
  int Size_Char;
  int i;
  int x_Pre = x;
  int y_Pre = y;
  han_font_t FontBuf;
  uint8_t font_width;
  resize_image_t r_src, r_dst;
  uint16_t pixel;
  int16_t x_pos;
  int16_t y_pos;
  float ratio;

  r_src.x = 0;
  r_src.y = 0;
  r_src.w = 0;
  r_src.h = 16;
  r_src.stride = 16;
  r_src.p_data = font_src_buffer;


  len = vsnprintf(print_buffer, 255, fmt, arg);
  va_end (arg);

  if (ratio_h > LCD_FONT_RESIZE_WIDTH)
  {
    ratio_h = LCD_FONT_RESIZE_WIDTH;
  }
  ratio = ratio_h / 16;

  x = 0;
  y = 0;
  for( i=0; i<len; i+=Size_Char )
  {
    hanFontLoad( &print_buffer[i], &FontBuf );


    disHanFontBuffer(x, y, &FontBuf, 0xFF);

    x_pos = x_Pre + x * ratio;
    y_pos = y_Pre + y * ratio;

    Size_Char = FontBuf.Size_Char;
    if (Size_Char >= 2)
    {
      font_width = 16;
      x += 2*8;
    }
    else
    {
      font_width = 8;
      x += 1*8;
    }

    r_src.w = font_width;

    //if ((x+font_width) > HW_LCD_WIDTH)
    if ((x_pos + font_width*ratio) >= HW_LCD_WIDTH)
    {
      x  = x_Pre;
      y += 16;

      x_pos = x_Pre + x * ratio;
      y_pos = y_Pre + y * ratio;
    }

    r_dst.x = 0;
    r_dst.y = 0;
    r_dst.w = r_src.w * ratio;
    r_dst.h = r_src.h * ratio;
    r_dst.stride = LCD_FONT_RESIZE_WIDTH;
    r_dst.p_data = font_dst_buffer;

    if (r_dst.w == 0) r_dst.w = 1;
    if (r_dst.h == 0) r_dst.h = 1;

    if (lcd_resize_mode == LCD_RESIZE_BILINEAR)
    {
      resizeImageFastGray(&r_src, &r_dst);
    }
    else
    {
      resizeImageNearest(&r_src, &r_dst);
    }


    for (int i_y=0; i_y<r_dst.h; i_y++)
    {
      for (int i_x=0; i_x<r_dst.w; i_x++)
      {
        pixel = font_dst_buffer[(i_y+r_dst.y)*LCD_FONT_RESIZE_WIDTH + i_x];
        if (pixel > 0)
        {
          lcdDrawPixelMix(x_pos+i_x, y_pos+i_y, color, pixel);
        }
      }
    }


    if( FontBuf.Code_Type == PHAN_END_CODE ) break;
  }
}

LCD_OPT_DEF void lcdPrintfRect(int x, int y, int w, int h, uint16_t color, float ratio, uint16_t align, const char *fmt, ...)
{
  va_list arg;
  va_start (arg, fmt);
  int32_t len;
  char print_buffer[256];
  int Size_Char;
  int i;
  int x_Pre = x;
  int y_Pre = y;
  han_font_t FontBuf;
  uint8_t font_width;
  resize_image_t r_src, r_dst;
  uint16_t pixel;
  int16_t x_pos;
  int16_t y_pos;
  uint32_t str_width;

  r_src.x = 0;
  r_src.y = 0;
  r_src.w = 0;
  r_src.h = 16;
  r_src.stride = 16;
  r_src.p_data = font_src_buffer;



  len = vsnprintf(print_buffer, 255, fmt, arg);
  va_end (arg);
  

  str_width = lcdGetStrWidth(fmt) * ratio;

  x = 0;
  y = 0;
  for( i=0; i<len; i+=Size_Char )
  {
    hanFontLoad( &print_buffer[i], &FontBuf );


    disHanFontBuffer(0, 0, &FontBuf, 0xFF);

    x_pos = x_Pre + x * ratio;
    y_pos = y_Pre + y * ratio;

    Size_Char = FontBuf.Size_Char;
    if (Size_Char >= 2)
    {
      font_width = 16;
      x += 2*8;
    }
    else
    {
      font_width = 8;
      x += 1*8;
    }

    r_src.w = font_width;

    if ((x_pos + font_width*ratio) >= HW_LCD_WIDTH)
    {
      x  = x_Pre;
      y += 16;

      x_pos = x_Pre + x * ratio;
      y_pos = y_Pre + y * ratio;
    }

    r_dst.x = 0;
    r_dst.y = 0;
    r_dst.w = r_src.w * ratio;
    r_dst.h = r_src.h * ratio;
    r_dst.stride = LCD_FONT_RESIZE_WIDTH;
    r_dst.p_data = font_dst_buffer;

    if (r_dst.w == 0) r_dst.w = 1;
    if (r_dst.h == 0) r_dst.h = 1;

    if (lcd_resize_mode == LCD_RESIZE_BILINEAR)
    {
      resizeImageFastGray(&r_src, &r_dst);
    }
    else
    {
      resizeImageNearest(&r_src, &r_dst);
    }

    int x_o = 0;
    int y_o = 0;


    if (w > str_width)
    {
      if (align & LCD_ALIGN_H_CENTER)
      {
        x_o += (w-str_width)/2;
      }
      if (align & LCD_ALIGN_H_RIGHT)
      {
        x_o += (w-str_width);
      }
    }
    if (h > r_dst.h)
    {
      if (align & LCD_ALIGN_V_CENTER)
      {
        y_o += (h-r_dst.h)/2 + 0;
      }
      if (align & LCD_ALIGN_V_BOTTOM)
      {
        y_o += (h-r_dst.h);
      }
    }


    for (int i_y=0; i_y<r_dst.h; i_y++)
    {
      for (int i_x=0; i_x<r_dst.w; i_x++)
      {
        pixel = font_dst_buffer[(i_y+r_dst.y)*LCD_FONT_RESIZE_WIDTH + i_x];
        if (pixel > 0)
        {
          lcdDrawPixelMix(x_o+x_pos+i_x, y_o+y_pos+i_y, color, pixel);
        }
      }
    }


    if( FontBuf.Code_Type == PHAN_END_CODE ) break;
  }
}

void lcdSetResizeMode(LcdResizeMode mode)
{
  lcd_resize_mode = mode;
}

#ifdef HW_LCD_LVGL
image_t lcdCreateImage(lvgl_img_t *p_lvgl, int16_t x, int16_t y, int16_t w, int16_t h)
{
  image_t ret;

  ret.x = x;
  ret.y = y;

  if (w > 0) ret.w = w;
  else       ret.w = p_lvgl->header.w;

  if (h > 0) ret.h = h;
  else       ret.h = p_lvgl->header.h;

  ret.p_img = p_lvgl;

  return ret;
}

LCD_OPT_DEF void IRAM_ATTR lcdDrawImage(image_t *p_img, int16_t draw_x, int16_t draw_y)
{
  int32_t o_x;
  int32_t o_y;  
  int16_t o_w;
  int16_t o_h;
  const uint16_t *p_data;
  uint16_t pixel;
  int16_t img_x = 0;
  int16_t img_y = 0;
  int16_t img_w = 0;
  int16_t img_h = 0;

  o_w = p_img->w;
  o_h = p_img->h;

  if (img_w > 0) o_w = img_w;
  if (img_h > 0) o_h = img_h;

  p_data = (uint16_t *)p_img->p_img->data;

  for (int yi=0; yi<o_h; yi++)
  {
    o_y = (p_img->y + yi + img_y);
    if (o_y >= p_img->p_img->header.h) break;

    o_y = o_y * p_img->p_img->header.w;
    for (int xi=0; xi<o_w; xi++)
    {
      o_x = p_img->x + xi + img_x;
      if (o_x >= p_img->p_img->header.w) break;

      pixel = p_data[o_y + o_x];
      if (pixel != green)
      {
        lcdDrawPixel(draw_x+xi, draw_y+yi, pixel);
      }
    }
  }  
}

#if HW_LCD_LOGO > 0
void lcdLogoOn(void)
{
  image_t logo;
  int16_t x, y;
  
  logo = lcdCreateImage(&logo_img, 0, 0, 0, 0);

  x = (lcdGetWidth() - logo.w) / 2;
  y = (lcdGetHeight() - logo.h) / 2;

  lcdClearBuffer(black);
  lcdDrawImage(&logo, x, y - 16);

  //lcdDrawRect(0, 0, LCD_WIDTH-0, LCD_HEIGHT-0, white);
  //lcdDrawRect(1, 1, LCD_WIDTH-2, LCD_HEIGHT-2, white);

  lcdUpdateDraw();

  is_logo_on = true;
}

void lcdLogoOff(void)
{
  lcdClearBuffer(black);
  lcdUpdateDraw();

  is_logo_on = false;
}

bool lcdLogoIsOn(void)
{
  return is_logo_on;
}
#endif

#endif

void cliLcd(cli_args_t *args)
{
  bool ret = false;


  if (args->argc == 1 && args->isStr(0, "info") == true)
  {
    cliPrintf("Driver : ST7701\n");
    cliPrintf("Width  : %d\n", LCD_WIDTH);
    cliPrintf("Height : %d\n", LCD_HEIGHT);
    cliPrintf("BKL    : %d%%\n", lcdGetBackLight());
    cliPrintf("Free Heap  : %ld KB\n", esp_get_free_heap_size()/1024);
    cliPrintf("Free Heapi : %d KB\n", esp_get_free_internal_heap_size()/1024);
    ret = true;
  }

  if (args->argc == 1 && args->isStr(0, "draw") == true)
  {
    
    uint32_t pre_time;
    uint32_t exe_time;

    for (int cnt=0; cnt<10; cnt++)
    {
      uint16_t color[3] = {red, green, blue};

      lcdClearBuffer(color[cnt%3]);

      pre_time = micros();
      lcdUpdateDraw();
      exe_time = micros()-pre_time;
      logPrintf("draw time : %d us, %d fps\n", exe_time, 1000000/exe_time);

      delay(500);
    }

    ret = true;
  }
 
  if (args->argc == 1 && args->isStr(0, "test") == true)
  {
    uint32_t cnt = 0;
    uint32_t fps = 0;
    uint32_t fps_time = 0;
    uint32_t draw_time = 0;

    lcdSetFont(LCD_FONT_HAN);

    while(cliKeepLoop())
    {
      uint32_t pre_time;
      uint32_t exe_time;

      if (lcdDrawAvailable() == true)
      {
        pre_time = micros();        
        lcdClearBuffer(black);

        lcdPrintf(25,16*0, green, "[LCD 테스트]");

        if (cnt%30 == 0)
        {
          fps = lcdGetFps();
          fps_time = lcdGetFpsTime();
          draw_time = lcdGetDrawTime();
        }

        lcdPrintf(0,16*1, white, "%d fps", fps);
        lcdPrintf(0,16*2, white, "%d ms fps" , fps_time);
        lcdPrintf(0,16*3, white, "%u ms draw" , draw_time);
        lcdPrintf(0,16*4, white, "%d fps draw" , 1000/draw_time);
        lcdPrintfResize(LCD_WIDTH-30, 16, white, 24, "%02d", cnt%100);
        lcdPrintfResize(LCD_WIDTH-40, 40, white, 32, "%02d", cnt%100);
        cnt++;

        lcdDrawFillRect( 0, 86, 10, 10, red);
        lcdDrawFillRect(10, 86, 10, 10, green);
        lcdDrawFillRect(20, 86, 10, 10, blue);

        lcdDrawFillRect(((cnt*3)%(LCD_WIDTH-100)), 100, 100, (LCD_HEIGHT-100), red);
        lcdDrawFillRect(((cnt*5)%(LCD_WIDTH-100)), 100, 100, (LCD_HEIGHT-100), green);
        lcdDrawFillRect(((cnt*6)%(LCD_WIDTH-100)), 100, 100, (LCD_HEIGHT-100), blue);

        exe_time = micros()-pre_time;
        lcdPrintf(0, 120, white, "draw %d ms", exe_time/1000);

        lcdRequestDraw();
      }
      delay(1);
    }
    lcdUpdateDraw();

    lcdClearBuffer(black);
    lcdUpdateDraw();

    ret = true;
  }

  if (args->argc == 1 && args->isStr(0, "touch") == true)
  {
    touch_info_t info;
    uint32_t cnt = 0;
    uint32_t fps = 0;
    uint32_t fps_time = 0;

    lcdSetFont(LCD_FONT_HAN);
    while(cliKeepLoop())
    {
      if (lcdDrawAvailable() == true)
      {
        lcdClearBuffer(black);

        lcdPrintf(25,16*0, green, "[TOUCH 테스트]");

        if (cnt%30 == 0)
        {
          fps = lcdGetFps();
          fps_time = lcdGetFpsTime();
        }
        cnt++;
        lcdPrintf(5,16*1, white, "%d fps", fps);
        lcdPrintf(5,16*2, white, "%d ms " , fps_time);
        

        touchGetInfo(&info);

        for (int i=0; i<info.count; i++)
        {
          uint16_t color[5] = {red, green, blue, pink, brown};
          int16_t x;
          int16_t y;
          int16_t size;

          x = info.point[i].x;
          y = info.point[i].y;
          size = info.point[i].w * 3;
          lcdPrintf(x, y-80, white, "%d:%d", x, y);
          lcdDrawFillCircle(x, y, size, color[info.point[i].id]);
        }     
        lcdRequestDraw();
      }
      delay(1);
    }

    lcdClear(black);

    ret = true;
  }

  if (args->argc == 2 && args->isStr(0, "bl") == true)
  {
    uint8_t bl_value;

    bl_value = args->getData(1);

    lcdSetBackLight(bl_value);

    ret = true;
  }

  if (ret != true)
  {
    cliPrintf("lcd info\n");
    cliPrintf("lcd draw\n");
    cliPrintf("lcd test\n");
    cliPrintf("lcd touch\n");
    cliPrintf("lcd bl 0~100\n");
  }
}
#endif
