chcbaram/macro-touchpad/firmware/main-bd/esp32-s3/components/esp32-s3-hal/hw/driver/i2c.c

/*
 * i2c.c
 *
 *  Created on: 2020. 12. 30.
 *      Author: baram
 */


#include "i2c.h"
#include "cli.h"
#include "driver/i2c.h"
#include "hal/i2c_hal.h"
#include "hal/gpio_hal.h"
#include "soc/i2c_periph.h"




#ifdef _USE_HW_I2C

#define lock()      xSemaphoreTake(mutex_lock, portMAX_DELAY);
#define unLock()    xSemaphoreGive(mutex_lock);

#ifdef _USE_HW_CLI
static void cliI2C(cli_args_t *args);
#endif



static uint32_t i2c_timeout[I2C_MAX_CH];
static uint32_t i2c_errcount[I2C_MAX_CH];
static uint32_t i2c_freq[I2C_MAX_CH];

static bool is_init = false;
static bool is_begin[I2C_MAX_CH];
static SemaphoreHandle_t mutex_lock;



typedef struct
{
  i2c_port_t i2c_num;
  int scl_pin;
  int sda_pin;
} i2c_tbl_t;

static i2c_tbl_t i2c_tbl[I2C_MAX_CH] =
    {
        {I2C_NUM_0, GPIO_NUM_15,  GPIO_NUM_7},
    };


static void delayUs(uint32_t us);



bool i2cInit(void)
{
  uint32_t i;


  for (i=0; i<I2C_MAX_CH; i++)
  {
    i2c_timeout[i] = 10;
    i2c_errcount[i] = 0;
    is_begin[i] = false;
  }

  mutex_lock = xSemaphoreCreateMutex();

#ifdef _USE_HW_CLI
  cliAdd("i2c", cliI2C);
#endif

  is_init = true;
  return true;
}

bool i2cIsInit(void)
{
  return is_init;
}

bool i2cBegin(uint8_t ch, uint32_t freq_khz)
{
  bool ret = false;
  esp_err_t esp_ret;
  i2c_config_t conf;


  if (ch >= I2C_MAX_CH)
  {
    return false;
  }


  switch(ch)
  {
    case _DEF_I2C1:
      i2c_freq[ch] = freq_khz;

      i2cReset(ch);

      if (is_begin[ch] == true)
      {
        i2c_driver_delete(i2c_tbl[ch].i2c_num);
      }

      conf.mode = I2C_MODE_MASTER;
      conf.sda_io_num = i2c_tbl[ch].sda_pin;
      conf.scl_io_num = i2c_tbl[ch].scl_pin;
      conf.sda_pullup_en = GPIO_PULLUP_ENABLE;
      conf.scl_pullup_en = GPIO_PULLUP_ENABLE;
      conf.master.clk_speed = freq_khz * 1000;
      conf.clk_flags = 0;

      esp_ret  = i2c_param_config(i2c_tbl[ch].i2c_num, &conf);
      esp_ret |= i2c_driver_install(i2c_tbl[ch].i2c_num, conf.mode, 0, 0, 0);
      if (esp_ret == ESP_OK)
      {
        ret = true;
        is_begin[ch] = true;
        logPrintf("[OK] i2cBegin(%d)\n", ch);
      }
      else
      {
        logPrintf("[NG] i2cBegin(%d)\n", ch);
      }
      break;
  }

  return ret;
}

bool i2cIsBegin(uint8_t ch)
{
  return is_begin[ch];
}

void i2cReset(uint8_t ch)
{
  i2c_tbl_t *p_pin = &i2c_tbl[ch];

  lock();
  gpio_reset_pin(p_pin->scl_pin);
  gpio_set_direction(p_pin->scl_pin, GPIO_MODE_OUTPUT);

  gpio_reset_pin(p_pin->sda_pin);
  gpio_set_direction(p_pin->sda_pin, GPIO_MODE_OUTPUT);


  gpio_set_level(p_pin->scl_pin, 1);
  gpio_set_level(p_pin->sda_pin, 1);
  delayUs(5);

  for (int i = 0; i < 9; i++)
  {
    gpio_set_level(p_pin->scl_pin, 0);
    delayUs(5);
    gpio_set_level(p_pin->scl_pin, 1);
    delayUs(5);
  }

  gpio_set_level(p_pin->scl_pin, 0);
  delayUs(5);
  gpio_set_level(p_pin->sda_pin, 0);
  delayUs(5);

  gpio_set_level(p_pin->scl_pin, 1);  
  delayUs(5);
  gpio_set_level(p_pin->sda_pin, 1);  
  unLock();
}

bool i2cIsDeviceReady(uint8_t ch, uint8_t dev_addr)
{
  uint8_t rx_data;
  esp_err_t esp_ret;

  if (ch >= I2C_MAX_CH) return false;
  if (is_begin[ch] == false) return false;

  lock();
  esp_ret = i2c_master_read_from_device(i2c_tbl[ch].i2c_num, 
                                        dev_addr,
                                        &rx_data, 
                                        1,
                                        10);
  unLock();

  if (esp_ret == ESP_OK)
  {
    return true;
  }

  return false;
}

bool i2cRecovery(uint8_t ch)
{
  bool ret;

  i2cReset(ch);

  ret = i2cBegin(ch, i2c_freq[ch]);

  return ret;
}

bool i2cReadByte (uint8_t ch, uint16_t dev_addr, uint16_t reg_addr, uint8_t *p_data, uint32_t timeout)
{
  return i2cReadBytes(ch, dev_addr, reg_addr, p_data, 1, timeout);
}

bool i2cReadBytes(uint8_t ch, uint16_t dev_addr, uint16_t reg_addr, uint8_t *p_data, uint32_t length, uint32_t timeout)
{
  bool ret = false;
  esp_err_t esp_ret = ESP_OK;

  if (ch >= I2C_MAX_CH) return false;
  if (i2cIsBegin(ch) == false) return false;

  lock();
  esp_ret = i2c_master_write_read_device(i2c_tbl[ch].i2c_num, 
                                        dev_addr, 
                                        (const uint8_t *)&reg_addr,
                                        1,
                                        p_data, 
                                        length, 
                                        timeout);
  unLock();

  if (esp_ret == ESP_OK)
  {
    ret = true;
  }

  return ret;
}

bool i2cRead16Bytes(uint8_t ch, uint16_t dev_addr, uint16_t reg_addr, uint8_t *p_data, uint32_t length, uint32_t timeout)
{
  bool ret = false;
  esp_err_t esp_ret = ESP_OK;
  uint8_t addr_buf[2];

  if (ch >= I2C_MAX_CH) return false;
  if (i2cIsBegin(ch) == false) return false;

  lock();
  addr_buf[0] = (reg_addr >> 8) & 0xFF;
  addr_buf[1] = (reg_addr >> 0) & 0xFF;
  esp_ret = i2c_master_write_read_device(i2c_tbl[ch].i2c_num, 
                                        dev_addr, 
                                        (const uint8_t *)addr_buf,
                                        2,
                                        p_data, 
                                        length, 
                                        timeout);
  unLock();

  if (esp_ret == ESP_OK)
  {
    ret = true;
  }

  return ret;
}

bool i2cReadData(uint8_t ch, uint16_t dev_addr, uint8_t *p_data, uint32_t length, uint32_t timeout)
{
  bool ret = false;
  esp_err_t esp_ret = ESP_OK;

  if (ch >= I2C_MAX_CH) return false;
  if (i2cIsBegin(ch) == false) return false;

  lock();
  esp_ret = i2c_master_read_from_device(i2c_tbl[ch].i2c_num, dev_addr, p_data, length, timeout);
  if (esp_ret == ESP_OK)
  {
    ret = true;
  }
  unLock();

  return ret;
}

bool i2cWriteByte (uint8_t ch, uint16_t dev_addr, uint16_t reg_addr, uint8_t data, uint32_t timeout)
{
  return i2cWriteBytes(ch, dev_addr, reg_addr, &data, 1, timeout);
}

bool i2cWriteBytes(uint8_t ch, uint16_t dev_addr, uint16_t reg_addr, uint8_t *p_data, uint32_t length, uint32_t timeout)
{
  bool ret = false;
  esp_err_t esp_ret = ESP_OK;
  uint8_t tx_buf[length+1];

  if (ch >= I2C_MAX_CH) return false;
  if (i2cIsBegin(ch) == false) return false;

  lock();
  tx_buf[0] = reg_addr;
  memcpy(&tx_buf[1], p_data, length);
  esp_ret = i2c_master_write_to_device(i2c_tbl[ch].i2c_num, dev_addr, tx_buf, length + 1, timeout);
  if (esp_ret == ESP_OK)
  {
    ret = true;
  }
  unLock();

  return ret;
}

bool i2cWrite16Bytes(uint8_t ch, uint16_t dev_addr, uint16_t reg_addr, uint8_t *p_data, uint32_t length, uint32_t timeout)
{
  bool ret = false;
  esp_err_t esp_ret = ESP_OK;
  uint8_t tx_buf[length+2];

  if (ch >= I2C_MAX_CH) return false;
  if (i2cIsBegin(ch) == false) return false;

  tx_buf[0] = (reg_addr >> 8) & 0xFF;
  tx_buf[1] = (reg_addr >> 0) & 0xFF;

  lock();
  memcpy(&tx_buf[2], p_data, length);
  esp_ret = i2c_master_write_to_device(i2c_tbl[ch].i2c_num, dev_addr, tx_buf, length + 2, timeout);
  if (esp_ret == ESP_OK)
  {
    ret = true;
  }
  unLock();

  return ret;
}

bool i2cWriteData(uint8_t ch, uint16_t dev_addr, uint8_t *p_data, uint32_t length, uint32_t timeout)
{
  bool ret = false;
  esp_err_t esp_ret = ESP_OK;

  if (ch >= I2C_MAX_CH) return false;
  if (i2cIsBegin(ch) == false) return false;

  lock();
  esp_ret = i2c_master_write_to_device(i2c_tbl[ch].i2c_num, dev_addr, p_data, length, timeout);
  if (esp_ret == ESP_OK)
  {
    ret = true;
  }
  unLock();

  return ret;
}

void i2cSetTimeout(uint8_t ch, uint32_t timeout)
{
  i2c_timeout[ch] = timeout;
}

uint32_t i2cGetTimeout(uint8_t ch)
{
  return i2c_timeout[ch];
}

void i2cClearErrCount(uint8_t ch)
{
  i2c_errcount[ch] = 0;
}

uint32_t i2cGetErrCount(uint8_t ch)
{
  return i2c_errcount[ch];
}

void delayUs(uint32_t us)
{
  volatile uint32_t i;

  for (i=0; i<us*1000; i++)
  {

  }
}


#ifdef _USE_HW_CLI
void cliI2C(cli_args_t *args)
{
  bool ret = false;
  bool i2c_ret;

  uint8_t print_ch;
  uint8_t ch;
  uint16_t dev_addr;
  uint16_t reg_addr;
  uint16_t length;

  uint32_t i;
  uint8_t i2c_data[128];
  uint32_t pre_time;


  if (args->argc == 2 && args->isStr(0, "scan") == true)
  {
    uint32_t dev_cnt = 0;
    print_ch = (uint16_t) args->getData(1);

    print_ch = constrain(print_ch, 1, I2C_MAX_CH);
    print_ch -= 1;

    for (i=0x00; i<= 0x7F; i++)
    {
      if (i2cIsDeviceReady(print_ch, i) == true)
      {
        cliPrintf("I2C CH%d Addr 0x%02X : OK\n", print_ch+1, i);
        dev_cnt++;
      }
    }
    if (dev_cnt == 0)
    {
      cliPrintf("no found\n");
    }
    ret = true;  
  }

  if (args->argc == 2 && args->isStr(0, "begin") == true)
  {
    print_ch = (uint16_t) args->getData(1);

    print_ch = constrain(print_ch, 1, I2C_MAX_CH);
    print_ch -= 1;

    i2c_ret = i2cBegin(print_ch, 400);
    if (i2c_ret == true)
    {
      cliPrintf("I2C CH%d Begin OK\n", print_ch + 1);
    }
    else
    {
      cliPrintf("I2C CH%d Begin Fail\n", print_ch + 1);
    }
    ret = true;
  }

  if (args->argc == 5 && args->isStr(0, "read") == true)
  {
    print_ch = (uint16_t) args->getData(1);
    print_ch = constrain(print_ch, 1, I2C_MAX_CH);

    dev_addr = (uint16_t) args->getData(2);
    reg_addr = (uint16_t) args->getData(3);
    length   = (uint16_t) args->getData(4);
    ch       = print_ch - 1;

    for (i=0; i<length; i++)
    {
      i2c_ret = i2cReadByte(ch, dev_addr, reg_addr+i, i2c_data, 100);

      if (i2c_ret == true)
      {
        cliPrintf("%d I2C - 0x%02X : 0x%02X\n", print_ch, reg_addr+i, i2c_data[0]);
      }
      else
      {
        cliPrintf("%d I2C - Fail \n", print_ch);
        break;
      }
    }
    ret = true;
  }

  if (args->argc == 5 && args->isStr(0, "reads") == true)
  {
    print_ch = (uint16_t) args->getData(1);
    print_ch = constrain(print_ch, 1, I2C_MAX_CH);

    dev_addr = (uint16_t) args->getData(2);
    reg_addr = (uint16_t) args->getData(3);
    length   = (uint16_t) args->getData(4);
    ch       = print_ch - 1;

    uint8_t rd_buf[length];

    i2c_ret = i2cReadBytes(ch, dev_addr, reg_addr, rd_buf, length, 100);

    for (i=0; i<length; i++)
    {
      if (i2c_ret == true)
      {
        cliPrintf("%d I2C - 0x%02X : 0x%02X\n", print_ch, reg_addr+i, rd_buf[i]);
      }
      else
      {
        cliPrintf("%d I2C - Fail \n", print_ch);
        break;
      }
    }
    ret = true;
  }

  if (args->argc == 5 && args->isStr(0, "write") == true)
  {
    print_ch = (uint16_t) args->getData(1);
    print_ch = constrain(print_ch, 1, I2C_MAX_CH);

    dev_addr = (uint16_t) args->getData(2);
    reg_addr = (uint16_t) args->getData(3);
    length   = (uint16_t) args->getData(4);
    ch       = print_ch - 1;

    pre_time = millis();
    i2c_ret = i2cWriteByte(ch, dev_addr, reg_addr, (uint8_t)length, 100);

    if (i2c_ret == true)
    {
      cliPrintf("%d I2C - 0x%02X : 0x%02X, %d ms\n", print_ch, reg_addr, length, millis()-pre_time);
    }
    else
    {
      cliPrintf("%d I2C - Fail \n", print_ch);
    }
    ret = true;
  }

  if (args->argc == 4 && args->isStr(0, "read_d") == true)
  {
    print_ch = (uint16_t) args->getData(1);
    print_ch = constrain(print_ch, 1, I2C_MAX_CH);

    dev_addr = (uint16_t) args->getData(2);
    length   = (uint16_t) args->getData(3);
    ch       = print_ch - 1;

    length   = constrain(length, 0, 256);  
    

    uint8_t buf[length];

    i2c_ret = i2cReadData(ch, dev_addr, buf, length, 100);
    if (i2c_ret == true)
    {
      for (int i=0; i<length; i++)
      {
        cliPrintf("%d I2C - 0x%02X : 0x%02X\n", print_ch, i, buf[i]);
      }
    }
    else
    {
      cliPrintf("%d I2C - Fail \n", print_ch);
    }
    ret = true;
  }



  if (ret == false)
  {
    cliPrintf( "i2c begin channel[1~%d]\n", I2C_MAX_CH);
    cliPrintf( "i2c scan channel[1~%d]\n", I2C_MAX_CH);
    cliPrintf( "i2c read channel dev_addr reg_addr length\n");
    cliPrintf( "i2c write channel dev_addr reg_addr data\n");
    cliPrintf( "i2c read_d channel dev_addr length\n");
    cliPrintf( "i2c write_d channel dev_addr data\n");
  }
}

#endif

#endif
