chcbaram/macro-touchpad/firmware/main-bd/stm32g031/stm32g031-fw/src/hw/driver/i2c.c

/*
 * i2c.c
 *
 *  Created on: 2020. 12. 30.
 *      Author: baram
 */


#include "i2c.h"
#include "cli.h"
#include "qbuffer.h"




#ifdef _USE_HW_I2C

#ifdef _USE_HW_CLI
static void cliI2C(cli_args_t *args);
#endif


#define I2C_RX_BUF_LENGTH     32



static uint32_t i2c_timeout[I2C_MAX_CH];
static uint32_t i2c_errcount[I2C_MAX_CH];
static uint32_t i2c_freq[I2C_MAX_CH];

static bool is_init = false;
static bool is_begin[I2C_MAX_CH];


static I2C_HandleTypeDef hi2c1;
static DMA_HandleTypeDef hdma_i2c1_rx;
static DMA_HandleTypeDef hdma_i2c1_tx;

typedef struct
{
  I2C_HandleTypeDef *p_hi2c;
  DMA_HandleTypeDef *p_hdma_rx;
  DMA_HandleTypeDef *p_hdma_tx;


  uint8_t  rx_buf[I2C_RX_BUF_LENGTH];
  qbuffer_t qbuffer;

  GPIO_TypeDef *scl_port;
  int           scl_pin;

  GPIO_TypeDef *sda_port;
  int           sda_pin;
} i2c_tbl_t;

static i2c_tbl_t i2c_tbl[I2C_MAX_CH];


static void delayUs(uint32_t us);





bool i2cInit(void)
{
  uint32_t i;


  for (i=0; i<I2C_MAX_CH; i++)
  {
    i2c_timeout[i] = 10;
    i2c_errcount[i] = 0;
    is_begin[i] = false;
  }

  i2c_tbl[0].p_hi2c   = &hi2c1;
  i2c_tbl[0].scl_port = GPIOB;
  i2c_tbl[0].scl_pin  = GPIO_PIN_6;
  i2c_tbl[0].sda_port = GPIOB;
  i2c_tbl[0].sda_pin  = GPIO_PIN_7;



#ifdef _USE_HW_CLI
  cliAdd("i2c", cliI2C);
#endif

  is_init = true;
  return true;
}

bool i2cIsInit(void)
{
  return is_init;
}

bool i2cBegin(uint8_t ch, uint32_t freq_khz)
{
  bool ret = false;

  I2C_HandleTypeDef *p_handle = i2c_tbl[ch].p_hi2c;

  if (ch >= I2C_MAX_CH)
  {
    return false;
  }


  switch(ch)
  {
    case _DEF_I2C1:
      i2c_freq[ch] = freq_khz;
      
      p_handle->Instance             = I2C1;
      p_handle->Init.Timing          = 0x00602173;
      p_handle->Init.OwnAddress1     = 0x0B<<1;
      p_handle->Init.AddressingMode  = I2C_ADDRESSINGMODE_7BIT;
      p_handle->Init.DualAddressMode = I2C_DUALADDRESS_DISABLE;
      p_handle->Init.OwnAddress2     = 0x00;
      p_handle->Init.OwnAddress2Masks= I2C_OA2_NOMASK;
      p_handle->Init.GeneralCallMode = I2C_GENERALCALL_ENABLE;
      p_handle->Init.NoStretchMode   = I2C_NOSTRETCH_DISABLE;

  
      i2c_tbl[ch].p_hdma_rx          = &hdma_i2c1_rx;


      qbufferCreate(&i2c_tbl[ch].qbuffer, &i2c_tbl[ch].rx_buf[0], I2C_RX_BUF_LENGTH);

      i2cReset(ch);

      HAL_I2C_DeInit(p_handle);
      if(HAL_I2C_Init(p_handle) != HAL_OK)
      {
        ret = false;
        is_begin[ch] = false;
        break;
      }

      /* Enable the Analog I2C Filter */
      HAL_I2CEx_ConfigAnalogFilter(p_handle,I2C_ANALOGFILTER_ENABLE);

      /* Configure Digital filter */
      HAL_I2CEx_ConfigDigitalFilter(p_handle, 0);

      // if(HAL_I2C_Slave_Receive_DMA(i2c_tbl[ch].p_hi2c, (uint8_t *)&i2c_tbl[ch].rx_buf[0], I2C_RX_BUF_LENGTH) != HAL_OK)
      // {
      //   ret = false;
      // }

      HAL_I2C_EnableListen_IT(p_handle);


      ret = true;
      is_begin[ch] = true;
      break;
  }

  return ret;
}

bool i2cIsBegin(uint8_t ch)
{
  return is_begin[ch];
}

void i2cReset(uint8_t ch)
{
  GPIO_InitTypeDef  GPIO_InitStruct;
  i2c_tbl_t *p_pin = &i2c_tbl[ch];


  GPIO_InitStruct.Pin       = p_pin->scl_pin;
  GPIO_InitStruct.Mode      = GPIO_MODE_OUTPUT_OD;
  GPIO_InitStruct.Pull      = GPIO_NOPULL;
  GPIO_InitStruct.Speed     = GPIO_SPEED_FREQ_HIGH;
  HAL_GPIO_Init(p_pin->scl_port, &GPIO_InitStruct);

  GPIO_InitStruct.Pin       = p_pin->sda_pin;
  GPIO_InitStruct.Mode      = GPIO_MODE_OUTPUT_OD;
  GPIO_InitStruct.Pull      = GPIO_NOPULL;
  HAL_GPIO_Init(p_pin->sda_port, &GPIO_InitStruct);


  HAL_GPIO_WritePin(p_pin->scl_port, p_pin->scl_pin, GPIO_PIN_SET);
  HAL_GPIO_WritePin(p_pin->sda_port, p_pin->sda_pin, GPIO_PIN_SET);
  delayUs(5);

  for (int i = 0; i < 9; i++)
  {

    HAL_GPIO_WritePin(p_pin->scl_port, p_pin->scl_pin, GPIO_PIN_RESET);
    delayUs(5);
    HAL_GPIO_WritePin(p_pin->scl_port, p_pin->scl_pin, GPIO_PIN_SET);
    delayUs(5);
  }

  HAL_GPIO_WritePin(p_pin->scl_port, p_pin->scl_pin, GPIO_PIN_RESET);
  delayUs(5);
  HAL_GPIO_WritePin(p_pin->sda_port, p_pin->sda_pin, GPIO_PIN_RESET);
  delayUs(5);

  HAL_GPIO_WritePin(p_pin->scl_port, p_pin->scl_pin, GPIO_PIN_SET);
  delayUs(5);
  HAL_GPIO_WritePin(p_pin->sda_port, p_pin->sda_pin, GPIO_PIN_SET);
}

bool i2cIsDeviceReady(uint8_t ch, uint8_t dev_addr)
{
  I2C_HandleTypeDef *p_handle = i2c_tbl[ch].p_hi2c;


  if (HAL_I2C_IsDeviceReady(p_handle, dev_addr << 1, 10, 10) == HAL_OK)
  {
    __enable_irq();
    return true;
  }

  return false;
}

bool i2cRecovery(uint8_t ch)
{
  bool ret;

  i2cReset(ch);

  ret = i2cBegin(ch, i2c_freq[ch]);

  return ret;
}

uint32_t i2cSlaveAvailable(uint8_t ch)
{
  uint32_t ret = 0;

  if (is_begin[ch] != true) return 0;
  
  switch(ch)
  {
    case _DEF_I2C1:
      i2c_tbl[ch].qbuffer.in = (i2c_tbl[ch].qbuffer.len - ((DMA_Channel_TypeDef *)i2c_tbl[ch].p_hdma_rx->Instance)->CNDTR);
      ret = qbufferAvailable(&i2c_tbl[ch].qbuffer);      
      break;
  }

  return ret;
}

uint8_t i2cSlaveRead(uint8_t ch)
{
  uint8_t ret = 0;

  switch(ch)
  {
    case _DEF_I2C1:
      qbufferRead(&i2c_tbl[ch].qbuffer, &ret, 1);
      break;
  }
  return ret;
}

bool i2cReadByte (uint8_t ch, uint16_t dev_addr, uint16_t reg_addr, uint8_t *p_data, uint32_t timeout)
{
  return i2cReadBytes(ch, dev_addr, reg_addr, p_data, 1, timeout);
}

bool i2cReadBytes(uint8_t ch, uint16_t dev_addr, uint16_t reg_addr, uint8_t *p_data, uint32_t length, uint32_t timeout)
{
  bool ret;
  HAL_StatusTypeDef i2c_ret;
  I2C_HandleTypeDef *p_handle = i2c_tbl[ch].p_hi2c;

  if (ch >= I2C_MAX_CH)
  {
    return false;
  }

  i2c_ret = HAL_I2C_Mem_Read(p_handle, (uint16_t)(dev_addr << 1), reg_addr, I2C_MEMADD_SIZE_8BIT, p_data, length, timeout);

  if( i2c_ret == HAL_OK )
  {
    ret = true;
  }
  else
  {
    ret = false;
  }

  return ret;
}

bool i2cReadData(uint8_t ch, uint16_t dev_addr, uint8_t *p_data, uint32_t length, uint32_t timeout)
{
  bool ret;
  HAL_StatusTypeDef i2c_ret;
  I2C_HandleTypeDef *p_handle = i2c_tbl[ch].p_hi2c;

  if (ch >= I2C_MAX_CH)
  {
    return false;
  }

  i2c_ret = HAL_I2C_Master_Receive(p_handle, (uint16_t)(dev_addr << 1), p_data, length, timeout);

  if( i2c_ret == HAL_OK )
  {
    ret = true;
  }
  else
  {
    ret = false;
  }

  return ret;
}

bool i2cWriteByte (uint8_t ch, uint16_t dev_addr, uint16_t reg_addr, uint8_t data, uint32_t timeout)
{
  return i2cWriteBytes(ch, dev_addr, reg_addr, &data, 1, timeout);
}

bool i2cWriteBytes(uint8_t ch, uint16_t dev_addr, uint16_t reg_addr, uint8_t *p_data, uint32_t length, uint32_t timeout)
{
  bool ret;
  HAL_StatusTypeDef i2c_ret;
  I2C_HandleTypeDef *p_handle = i2c_tbl[ch].p_hi2c;

  if (ch >= I2C_MAX_CH)
  {
    return false;
  }

  i2c_ret = HAL_I2C_Mem_Write(p_handle, (uint16_t)(dev_addr << 1), reg_addr, I2C_MEMADD_SIZE_8BIT, p_data, length, timeout);

  if(i2c_ret == HAL_OK)
  {
    ret = true;
  }
  else
  {
    ret = false;
  }

  return ret;
}

bool i2cWriteData(uint8_t ch, uint16_t dev_addr, uint8_t *p_data, uint32_t length, uint32_t timeout)
{
  bool ret;
  HAL_StatusTypeDef i2c_ret;
  I2C_HandleTypeDef *p_handle = i2c_tbl[ch].p_hi2c;

  if (ch >= I2C_MAX_CH)
  {
    return false;
  }


  i2c_ret = HAL_I2C_Master_Transmit(p_handle, (uint16_t)(dev_addr << 1), p_data, length, timeout);

  if(i2c_ret == HAL_OK)
  {
    ret = true;
  }
  else
  {
    ret = false;
  }

  return ret;
}

void i2cSetTimeout(uint8_t ch, uint32_t timeout)
{
  i2c_timeout[ch] = timeout;
}

uint32_t i2cGetTimeout(uint8_t ch)
{
  return i2c_timeout[ch];
}

void i2cClearErrCount(uint8_t ch)
{
  i2c_errcount[ch] = 0;
}

uint32_t i2cGetErrCount(uint8_t ch)
{
  return i2c_errcount[ch];
}

void delayUs(uint32_t us)
{
  volatile uint32_t i;

  for (i=0; i<us*1000; i++)
  {

  }
}

__weak void i2cReadCallback(uint8_t addr, uint8_t *p_data)
{
}

__weak void i2cWriteCallback(uint8_t addr, uint8_t *p_data)
{
  
}

typedef enum
{
  I2C_CMD_IDLE,
  I2C_CMD_GET_ADDR, 
  I2C_CMD_WR_DATA,
  I2C_CMD_RD_DATA,
} i2c_cmd_t;


volatile i2c_cmd_t i2c_cmd_state = I2C_CMD_IDLE;
volatile bool i2c_cmd_done = false;


static uint8_t i2c_rx_buf[2];
static uint8_t i2c_tx_buf[2];

uint8_t i2c_cmd_addr = 0;

#ifdef I2C_SEQ_DEBUG
uint8_t i2c_seq_buf[16];
uint8_t i2c_seq_i;
#endif


void HAL_I2C_AddrCallback(I2C_HandleTypeDef *hi2c, uint8_t TransferDirection, uint16_t AddrMatchCode)
{
  switch(TransferDirection)
  {
    case I2C_DIRECTION_TRANSMIT:   
      i2c_cmd_state = I2C_CMD_GET_ADDR;
      HAL_I2C_Slave_Seq_Receive_DMA(hi2c, i2c_rx_buf, 1, I2C_FIRST_FRAME);
      i2c_cmd_done = false;
      #ifdef I2C_SEQ_DEBUG
      i2c_seq_i = 0;
      memset(i2c_seq_buf, 0, sizeof(i2c_seq_buf));
      i2c_seq_buf[i2c_seq_i++] = 1;
      #endif
      break;

    case I2C_DIRECTION_RECEIVE:
      i2c_cmd_state = I2C_CMD_RD_DATA;
      i2cReadCallback(i2c_cmd_addr, i2c_tx_buf);
      i2c_cmd_addr++;
      HAL_I2C_Slave_Seq_Transmit_DMA(hi2c, i2c_tx_buf, 1, I2C_NEXT_FRAME);
      #ifdef I2C_SEQ_DEBUG
      i2c_seq_buf[i2c_seq_i++] = 2;
      #endif
      break;
  }
}

void HAL_I2C_ListenCpltCallback(I2C_HandleTypeDef *hi2c)
{
  i2c_cmd_done = true;
  HAL_I2C_EnableListen_IT(hi2c);

  #ifdef I2C_SEQ_DEBUG
  i2c_seq_buf[i2c_seq_i++] = 8;
  #endif
}

void HAL_I2C_ErrorCallback(I2C_HandleTypeDef *hi2c)
{
  if (hi2c->ErrorCode & HAL_I2C_ERROR_AF)
  {
    #ifdef I2C_SEQ_DEBUG
    i2c_seq_buf[i2c_seq_i++] = 3;
    #endif
  }
  else if (hi2c->ErrorCode > 0)
  {
    return;
  }

}

void HAL_I2C_SlaveRxCpltCallback(I2C_HandleTypeDef *hi2c)
{
  switch(i2c_cmd_state)
  {
    case I2C_CMD_GET_ADDR:
      i2c_cmd_addr = i2c_rx_buf[0];
      i2c_cmd_state = I2C_CMD_WR_DATA;
      HAL_I2C_Slave_Seq_Receive_DMA(hi2c, i2c_rx_buf, 1, I2C_FIRST_FRAME);
      
      #ifdef I2C_SEQ_DEBUG
      i2c_seq_buf[i2c_seq_i++] = 4;
      #endif
      break;

    case I2C_CMD_WR_DATA:
      i2cWriteCallback(i2c_cmd_addr, i2c_rx_buf);
      HAL_I2C_Slave_Seq_Receive_DMA(hi2c, i2c_rx_buf, 1, I2C_LAST_FRAME);    

      #ifdef I2C_SEQ_DEBUG
      i2c_seq_buf[i2c_seq_i++] = 5;
      #endif
      break;

    default:
      break;
  }
}

void HAL_I2C_SlaveTxCpltCallback(I2C_HandleTypeDef *hi2c)
{
  if (i2c_cmd_done == true)
    return;

  switch(i2c_cmd_state)
  {
    case I2C_CMD_RD_DATA:
      i2cReadCallback(i2c_cmd_addr, i2c_tx_buf);
      i2c_cmd_addr++;
      HAL_I2C_Slave_Seq_Transmit_DMA(hi2c, i2c_tx_buf, 1, I2C_NEXT_FRAME);

      #ifdef I2C_SEQ_DEBUG
      i2c_seq_buf[i2c_seq_i++] = 6;
      #endif
      break;

    default:
      break;
  }
}

void HAL_I2C_AbortCpltCallback(I2C_HandleTypeDef *hi2c)
{
  return;
}

void I2C1_IRQHandler(void)
{
  if (hi2c1.Instance->ISR & (I2C_FLAG_BERR | I2C_FLAG_ARLO | I2C_FLAG_OVR)) 
  {
    HAL_I2C_ER_IRQHandler(&hi2c1);
  } 
  else 
  {
    HAL_I2C_EV_IRQHandler(&hi2c1);
  }
}

void DMA1_Channel2_3_IRQHandler(void)
{
  HAL_DMA_IRQHandler(&hdma_i2c1_rx);
  HAL_DMA_IRQHandler(&hdma_i2c1_tx);  
}

void HAL_I2C_MspInit(I2C_HandleTypeDef* i2cHandle)
{
  GPIO_InitTypeDef GPIO_InitStruct = {0};
  RCC_PeriphCLKInitTypeDef PeriphClkInit = {0};

  if(i2cHandle->Instance==I2C1)
  {
  /** Initializes the peripherals clocks
  */
    PeriphClkInit.PeriphClockSelection = RCC_PERIPHCLK_I2C1;
    PeriphClkInit.I2c1ClockSelection = RCC_I2C1CLKSOURCE_PCLK1;
    if (HAL_RCCEx_PeriphCLKConfig(&PeriphClkInit) != HAL_OK)
    {
      Error_Handler();
    }

    __HAL_RCC_GPIOB_CLK_ENABLE();
    /**I2C1 GPIO Configuration
    PB6     ------> I2C1_SCL
    PB7     ------> I2C1_SDA
    */
    GPIO_InitStruct.Pin = GPIO_PIN_6|GPIO_PIN_7;
    GPIO_InitStruct.Mode = GPIO_MODE_AF_OD;
    GPIO_InitStruct.Pull = GPIO_NOPULL;
    GPIO_InitStruct.Speed = GPIO_SPEED_FREQ_LOW;
    GPIO_InitStruct.Alternate = GPIO_AF6_I2C1;
    HAL_GPIO_Init(GPIOB, &GPIO_InitStruct);

    /* I2C1 clock enable */
    __HAL_RCC_I2C1_CLK_ENABLE();

    __HAL_RCC_DMA1_CLK_ENABLE();

    /* I2C1 DMA Init */
    /* I2C1_RX Init */
    hdma_i2c1_rx.Instance = DMA1_Channel2;
    hdma_i2c1_rx.Init.Request = DMA_REQUEST_I2C1_RX;
    hdma_i2c1_rx.Init.Direction = DMA_PERIPH_TO_MEMORY;
    hdma_i2c1_rx.Init.PeriphInc = DMA_PINC_DISABLE;
    hdma_i2c1_rx.Init.MemInc = DMA_MINC_ENABLE;
    hdma_i2c1_rx.Init.PeriphDataAlignment = DMA_PDATAALIGN_BYTE;
    hdma_i2c1_rx.Init.MemDataAlignment = DMA_MDATAALIGN_BYTE;
    hdma_i2c1_rx.Init.Mode = DMA_NORMAL;
    hdma_i2c1_rx.Init.Priority = DMA_PRIORITY_LOW;
    if (HAL_DMA_Init(&hdma_i2c1_rx) != HAL_OK)
    {
      Error_Handler();
    }

    __HAL_LINKDMA(i2cHandle,hdmarx,hdma_i2c1_rx);


    /* I2C1_TX Init */
    hdma_i2c1_tx.Instance = DMA1_Channel3;
    hdma_i2c1_tx.Init.Request = DMA_REQUEST_I2C1_TX;
    hdma_i2c1_tx.Init.Direction = DMA_MEMORY_TO_PERIPH;
    hdma_i2c1_tx.Init.PeriphInc = DMA_PINC_DISABLE;
    hdma_i2c1_tx.Init.MemInc = DMA_MINC_ENABLE;
    hdma_i2c1_tx.Init.PeriphDataAlignment = DMA_PDATAALIGN_BYTE;
    hdma_i2c1_tx.Init.MemDataAlignment = DMA_MDATAALIGN_BYTE;
    hdma_i2c1_tx.Init.Mode = DMA_NORMAL;
    hdma_i2c1_tx.Init.Priority = DMA_PRIORITY_LOW;
    if (HAL_DMA_Init(&hdma_i2c1_tx) != HAL_OK)
    {
      Error_Handler();
    }

    __HAL_LINKDMA(i2cHandle,hdmatx,hdma_i2c1_tx);


    /* I2C1 interrupt Init */
    HAL_NVIC_SetPriority(I2C1_IRQn, 3, 0);
    HAL_NVIC_EnableIRQ(I2C1_IRQn);

    /* DMA1_Channel2_3_IRQn interrupt configuration */
    HAL_NVIC_SetPriority(DMA1_Channel2_3_IRQn, 2, 0);
    HAL_NVIC_EnableIRQ(DMA1_Channel2_3_IRQn);    
  }
}

void HAL_I2C_MspDeInit(I2C_HandleTypeDef* i2cHandle)
{

  if(i2cHandle->Instance==I2C1)
  {
    /* Peripheral clock disable */
    __HAL_RCC_I2C1_CLK_DISABLE();

    /**I2C1 GPIO Configuration
    PB6     ------> I2C1_SCL
    PB7     ------> I2C1_SDA
    */
    HAL_GPIO_DeInit(GPIOB, GPIO_PIN_6);

    HAL_GPIO_DeInit(GPIOB, GPIO_PIN_7);

    /* I2C1 interrupt Deinit */
    HAL_NVIC_DisableIRQ(I2C1_IRQn);
  }
}


#ifdef _USE_HW_CLI
void cliI2C(cli_args_t *args)
{
  bool ret = true;
  bool i2c_ret;

  uint8_t print_ch;
  uint8_t ch;
  uint16_t dev_addr;
  uint16_t reg_addr;
  uint16_t length;

  uint32_t i;
  uint8_t i2c_data[128];
  uint32_t pre_time;


  if (args->argc == 2)
  {
    print_ch = (uint16_t) args->getData(1);

    print_ch = constrain(print_ch, 1, I2C_MAX_CH);
    print_ch -= 1;

    if(args->isStr(0, "scan") == true)
    {
      if (i2cIsBegin(print_ch) == true)
      {
        for (i=0x00; i<= 0x7F; i++)
        {
          if (i2cIsDeviceReady(print_ch, i) == true)
          {
            cliPrintf("I2C CH%d Addr 0x%02X : OK\n", print_ch+1, i);
          }
        }
      }
      else
      {
        cliPrintf("i2c ch%d is not begin\n", print_ch + 1);
      }
    }
    else if(args->isStr(0, "begin") == true)
    {
      i2c_ret = i2cBegin(print_ch, 400);
      if (i2c_ret == true)
      {
        cliPrintf("I2C CH%d Begin OK\n", print_ch + 1);
      }
      else
      {
        cliPrintf("I2C CH%d Begin Fail\n", print_ch + 1);
      }
    }
  }
  else if (args->argc == 5)
  {
    print_ch = (uint16_t) args->getData(1);
    print_ch = constrain(print_ch, 1, I2C_MAX_CH);

    dev_addr = (uint16_t) args->getData(2);
    reg_addr = (uint16_t) args->getData(3);
    length   = (uint16_t) args->getData(4);
    ch       = print_ch - 1;

    if(args->isStr(0, "read") == true)
    {
      for (i=0; i<length; i++)
      {
        i2c_ret = i2cReadByte(ch, dev_addr, reg_addr+i, i2c_data, 100);

        if (i2c_ret == true)
        {
          cliPrintf("%d I2C - 0x%02X : 0x%02X\n", print_ch, reg_addr+i, i2c_data[0]);
        }
        else
        {
          cliPrintf("%d I2C - Fail \n", print_ch);
          break;
        }
      }
    }
    else if(args->isStr(0, "write") == true)
    {
      pre_time = millis();
      i2c_ret = i2cWriteByte(ch, dev_addr, reg_addr, (uint8_t)length, 100);

      if (i2c_ret == true)
      {
        cliPrintf("%d I2C - 0x%02X : 0x%02X, %d ms\n", print_ch, reg_addr, length, millis()-pre_time);
      }
      else
      {
        cliPrintf("%d I2C - Fail \n", print_ch);
      }
    }
    else
    {
      ret = false;
    }
  }
  else
  {
    ret = false;
  }

  if (ret == false)
  {
    cliPrintf( "i2c begin ch[1~%d]\n", I2C_MAX_CH);
    cliPrintf( "i2c scan  ch[1~%d]\n", I2C_MAX_CH);
    cliPrintf( "i2c read  ch dev_addr reg_addr length\n");
    cliPrintf( "i2c write ch dev_addr reg_addr data\n");
  }
}

#endif

#endif
