chcbaram/macro-touchpad/firmware/main-bd/esp32-s3/components/esp32-s3-hal/hw/hw.c

/*
 * hw.c
 *
 *  Created on: 2021. 1. 9.
 *      Author: baram
 */




#include "hw.h"



static void bootMsg(void);




bool hwInit(void)
{
  bspInit();


  cliInit();
  logInit();

  cdcInit();
  uartInit();
  uartOpen(_DEF_UART1, 115200);

  logOpen(HW_LOG_CH, 115200);

  bootMsg();
  logPrintf("\r\n[ Firmware Begin... ]\r\n");
  logPrintf("Booting..Name \t\t: %s\r\n", _DEF_BOARD_NAME);
  logPrintf("Booting..Ver  \t\t: %s\r\n", _DEF_FIRMWATRE_VERSION);  
  logPrintf("\n");

  nvsInit();
  i2cInit();
  i2cExpInit();
  i2sInit();
  gpioInit();
  pwmInit();
  adcInit();
  audioInit();
  buzzerInit();
  batteryInit();
  touchInit();
  lcdInit();

  return true;
}

void bootMsg(void)
{
  logPrintf("\r\n[ ESP32-S3 Info ]\r\n");
  logPrintf("ESP32-S3-LCD !\n");

  /* Print chip information */
  esp_chip_info_t chip_info;
  esp_chip_info(&chip_info);
  logPrintf("This is %s chip with %d CPU core(s), WiFi%s%s, ",
          CONFIG_IDF_TARGET,
          chip_info.cores,
          (chip_info.features & CHIP_FEATURE_BT) ? "/BT" : "",
          (chip_info.features & CHIP_FEATURE_BLE) ? "/BLE" : "");

  logPrintf("silicon revision %d\n", chip_info.revision);

  uint32_t flash_size = 0;
  esp_flash_get_size(NULL, &flash_size);
  logPrintf("SPI FLASH : %uMB %s flash\n", flash_size / (1024 * 1024),
          (chip_info.features & CHIP_FEATURE_EMB_FLASH) ? "embedded" : "external");


  logPrintf("SPI PSRAM : %dMB\n", esp_psram_get_size()/1024/1024);

  logPrintf("Free heap : %ld KB\n", esp_get_free_heap_size()/1024);
  logPrintf("Free Heapi: %d KB\n", esp_get_free_internal_heap_size()/1024);
  logPrintf("CPU Freq  : %lu Mhz\n", bspGetCpuFreqMhz());
}
