chcbaram/macro-touchpad/(commit log)

2023-05-20 하드웨어 파일 추가
    [BOM_MAIN-BD_PCB_2023-05-19.xlsx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]
2023-05-20 기본 프로젝트 추가
    [partitions.csv]
2023-05-20 esp32-s3 폴더 변경
    [partitions.csv]
2023-05-21 - STM32G031 프로젝트 추가 - I2S 추가
2023-05-21 전원 ON/OFF 추가
2023-05-21 LCD 백라이트 GPIO 추가
2023-05-22 I2C 추가, GT911 디버깅 중..
2023-05-27 I2C SLAVE 추가
2023-05-28 I2C Exp 추가
2023-05-28 ST7701 초기화 추가
2023-05-28 LCD 작업중..
2023-05-29 LCD 디버깅 중..
2023-05-29 LCD 디버깅
2023-05-29 LCD 백라이트 기본 OFF로 변경
2023-05-31 GT911 터치 디버깅 완료
2023-05-31 LCD 처리 방식 변경
2023-05-31 LVGL 예제 추가
2023-06-01 LCD PWM 추가
2023-06-01 ADC, 배터리 처리 추가
2023-06-01 LVGL 예제 변경
2023-06-01 코드 정리
2023-06-02 LCD PWM 25KHz로 변경
