chcbaram/macro-touchpad/(notices)

Notices in the files:
firmware/main-bd/stm32g031/cube/Core/Inc/main.h:
Copyright (c) 2023 STMicroelectronics.
All rights reserved.
This software is licensed under terms that can be found in the LICENSE file
